sgoldaraz/mcu-board/PCB-RevA/OpenBotBrainREVA.pdf

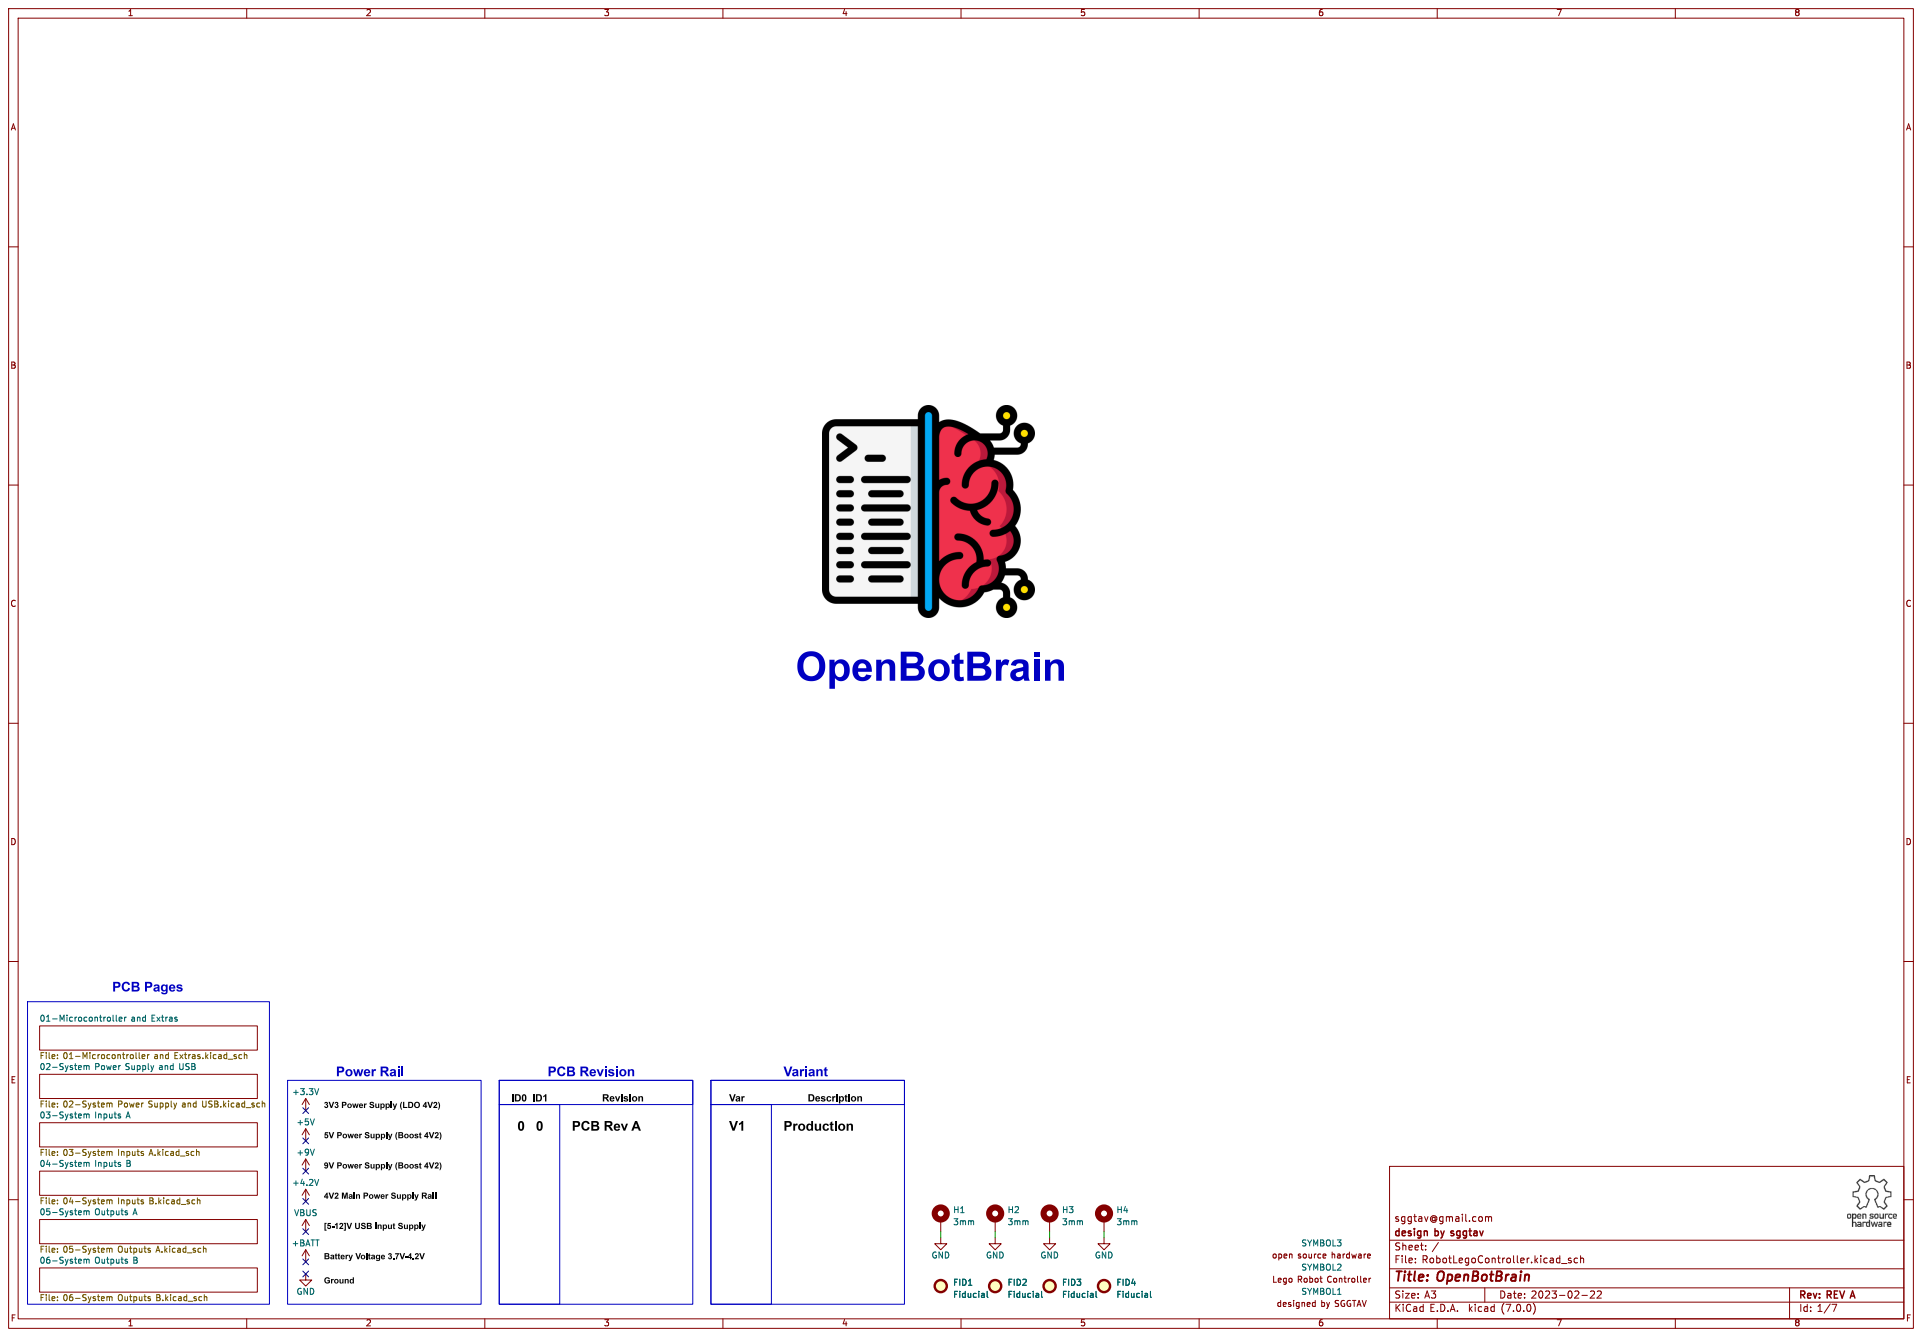
[picture p1: page 1]

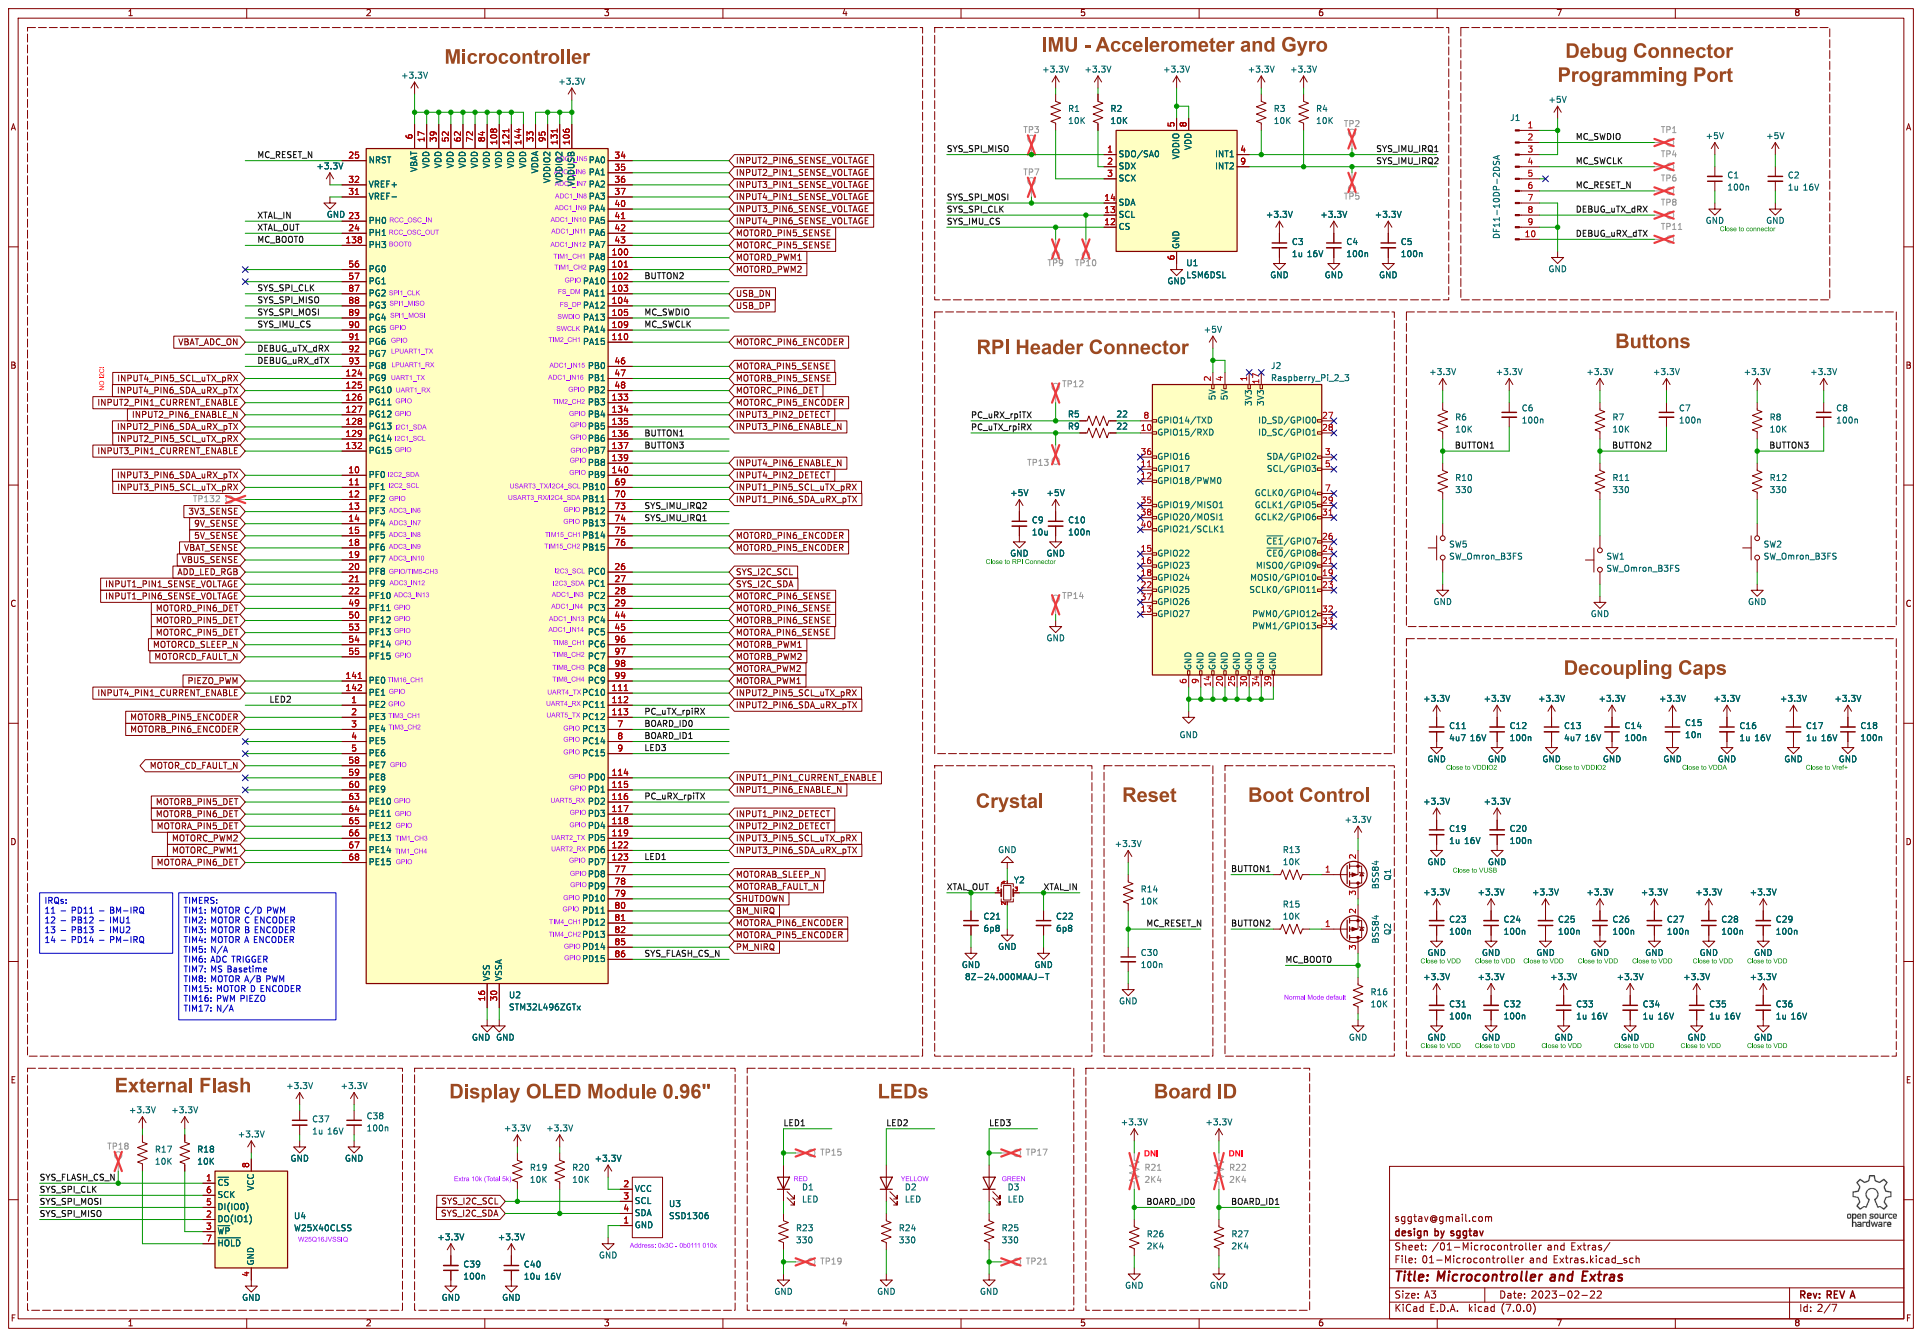
[picture p2: page 2]

IMU - Accelerometer and Gyro

SDO/SA0 1 CS 12 SCL 13 SDA 14 SDX 2 SCX 3

LSM6DSL SDO/SA0 1 CS 12 SCL 13 SDA 14 SDX 2 SCX 3

Normal Mode default RPI Header Connector

2 3 Q2 BSS84 GND GND GND GND

Close to VDDIO2 TIM4_CH1 GPIO
GPIO
Close to VDD GPIO
UART5_RX UART2_TX GPIO

Close to Vref+ GPIO

Close to VDDA GPIO

Close to VDDIO2 Board ID

TIM2: MOTOR C ENCODER
TIM3: MOTOR B ENCODER
TIM4: MOTOR A ENCODER
TIM5: N/A
TIM6: ADC TRIGGER
TIM7: MS Basetime TIM8: MOTOR A/B PWM

Close to VDD Display OLED Module 0.96"

4 DI(IO0) 5 SCK 6 ~{HOLD} 7 VCC

Id: 2/7 Title: Microcontroller and Extras

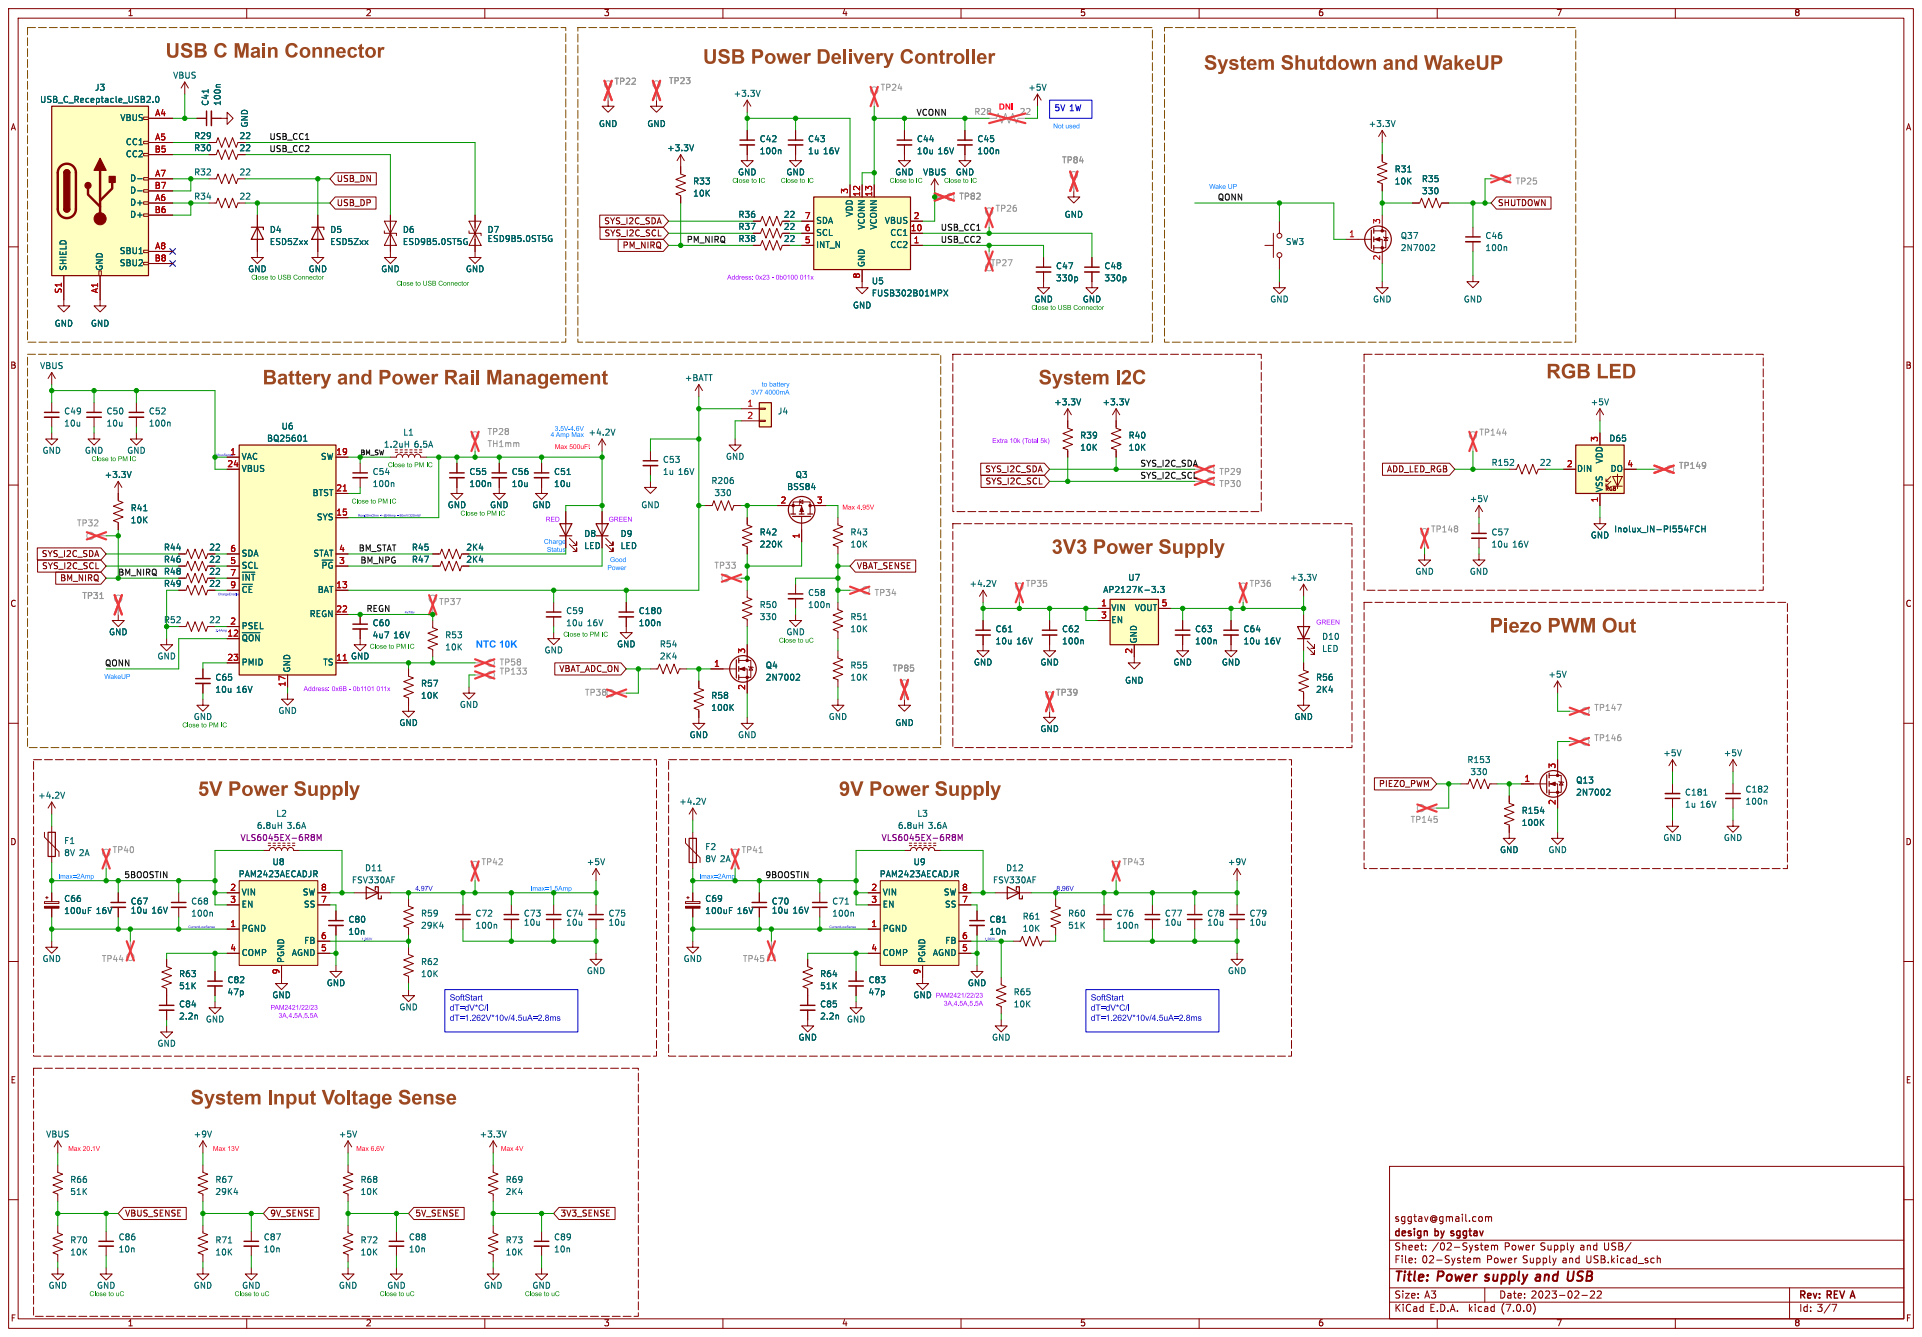
[picture p3: page 3]

Close to USB Connector Close to USB Connector USB C Main Connector

Wake UP 5V Power Supply

GND
Close to USB Connector

Extra 10k (Total 5k) Max 500uF! Close to PM IC Battery and Power Rail Management

10K GND
Close to PM IC

Good Power System Input Voltage Sense

1.262V Close to uC Max 13V

SoftStart dT=dV*C/I dT=1.262V*10v/4.5uA=2.8ms

Close to uC Max 20.1V

Id: 3/7 Title: Power supply and USB

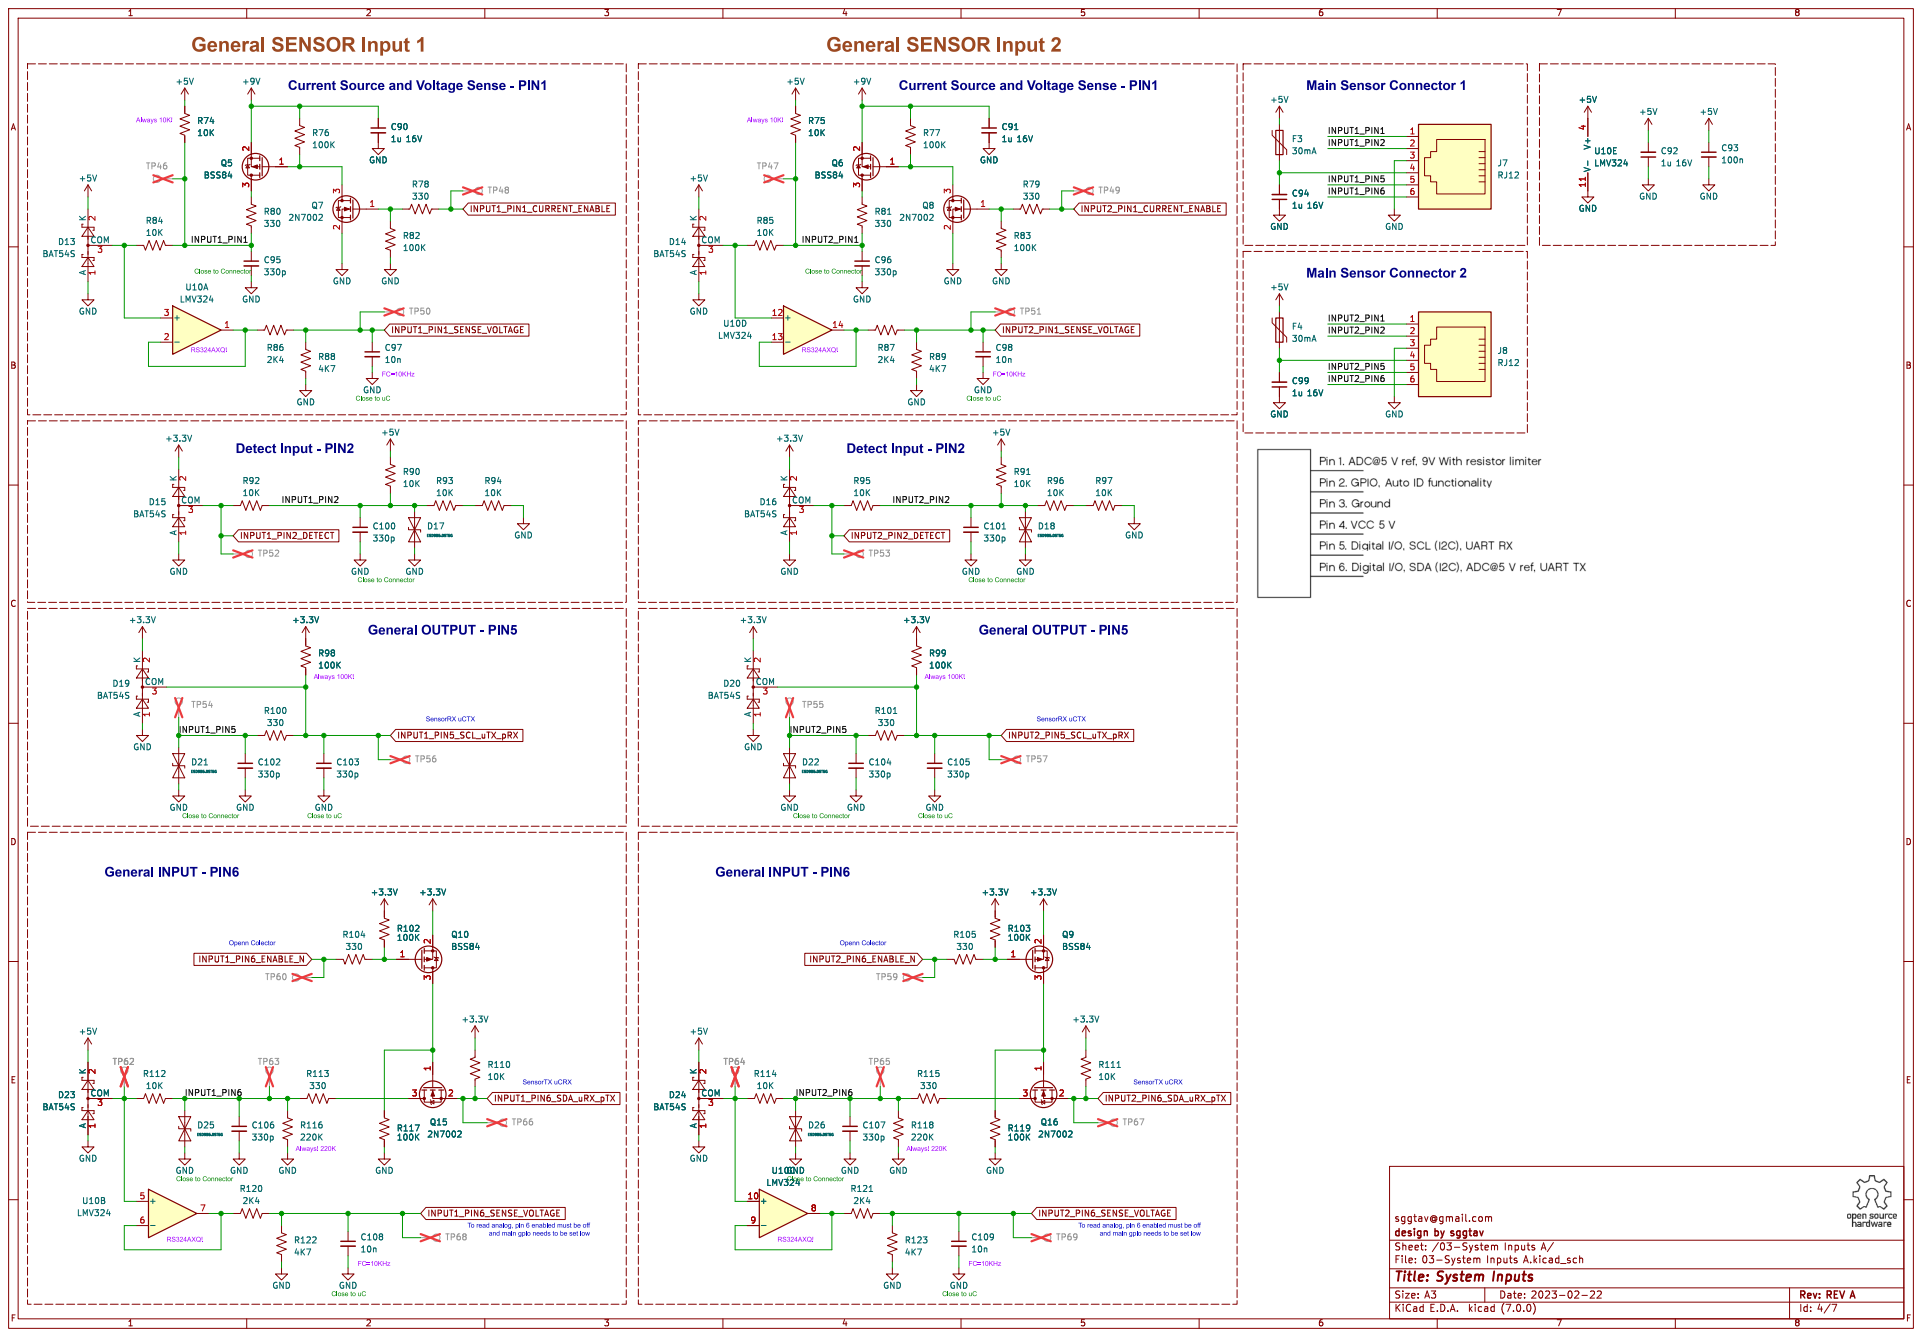
[picture p4: page 4]

FC=10KHz General SENSOR Input 2

RS324AXQ! Close to uC Current Source and Voltage Sense - PIN1

Current Source and Voltage Sense - PIN1

Close to Connector General INPUT - PIN6

Always 100K! Close to Connector

GND
SensorTX uCRX Close to Connector

SensorTX uCRX General INPUT - PIN6

To read analog, pin 6 enabled must be off and main gpio needs to be set low Openn Colector

Id: 4/7 Title: System Inputs

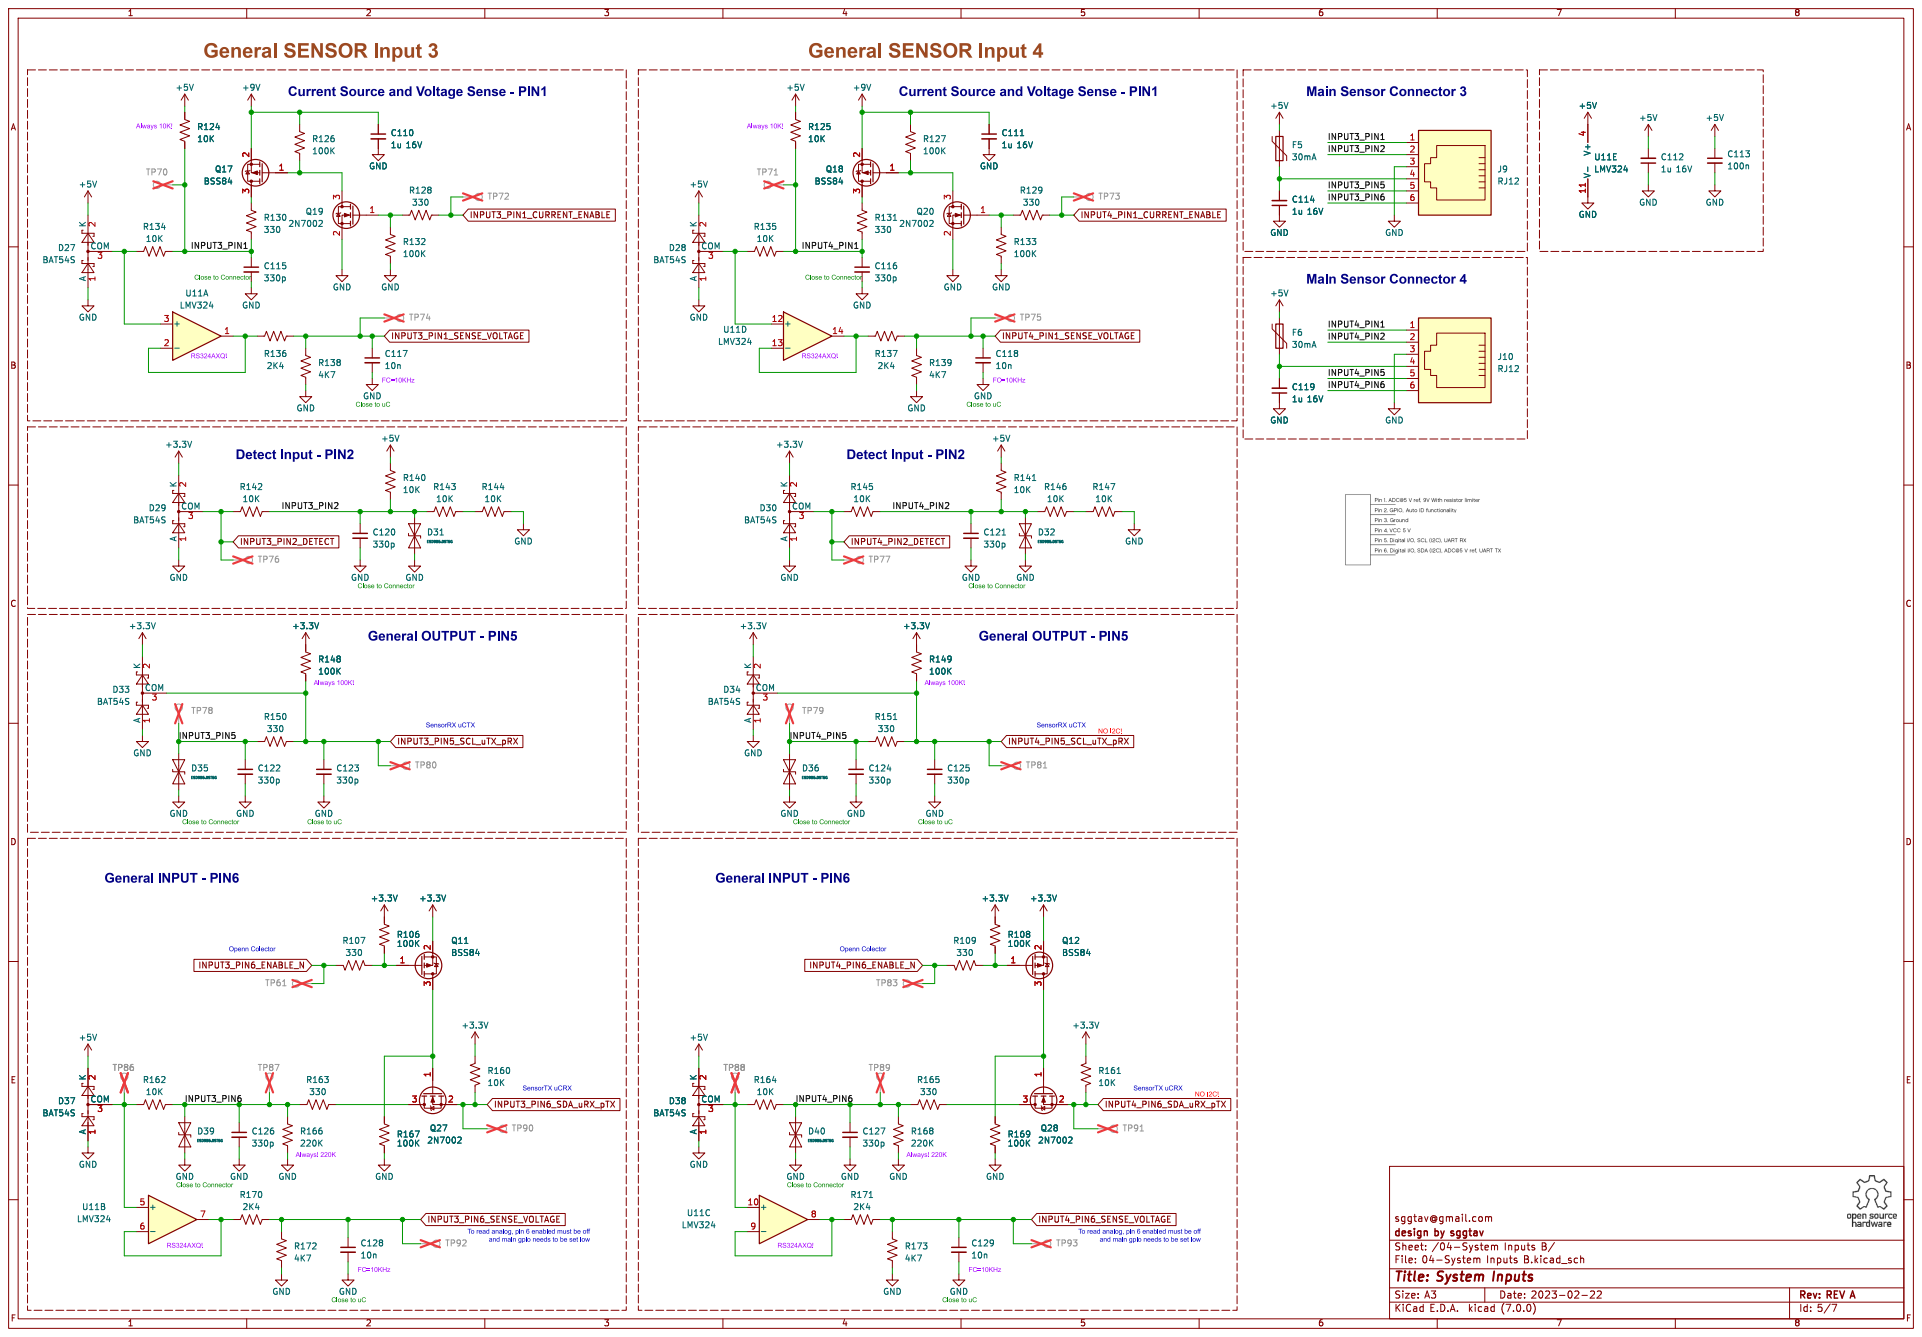
[picture p5: page 5]

Close to Connector General INPUT - PIN6

Openn Colector General INPUT - PIN6

SensorTX uCRX Close to uC

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

Id: 5/7 Title: System Inputs

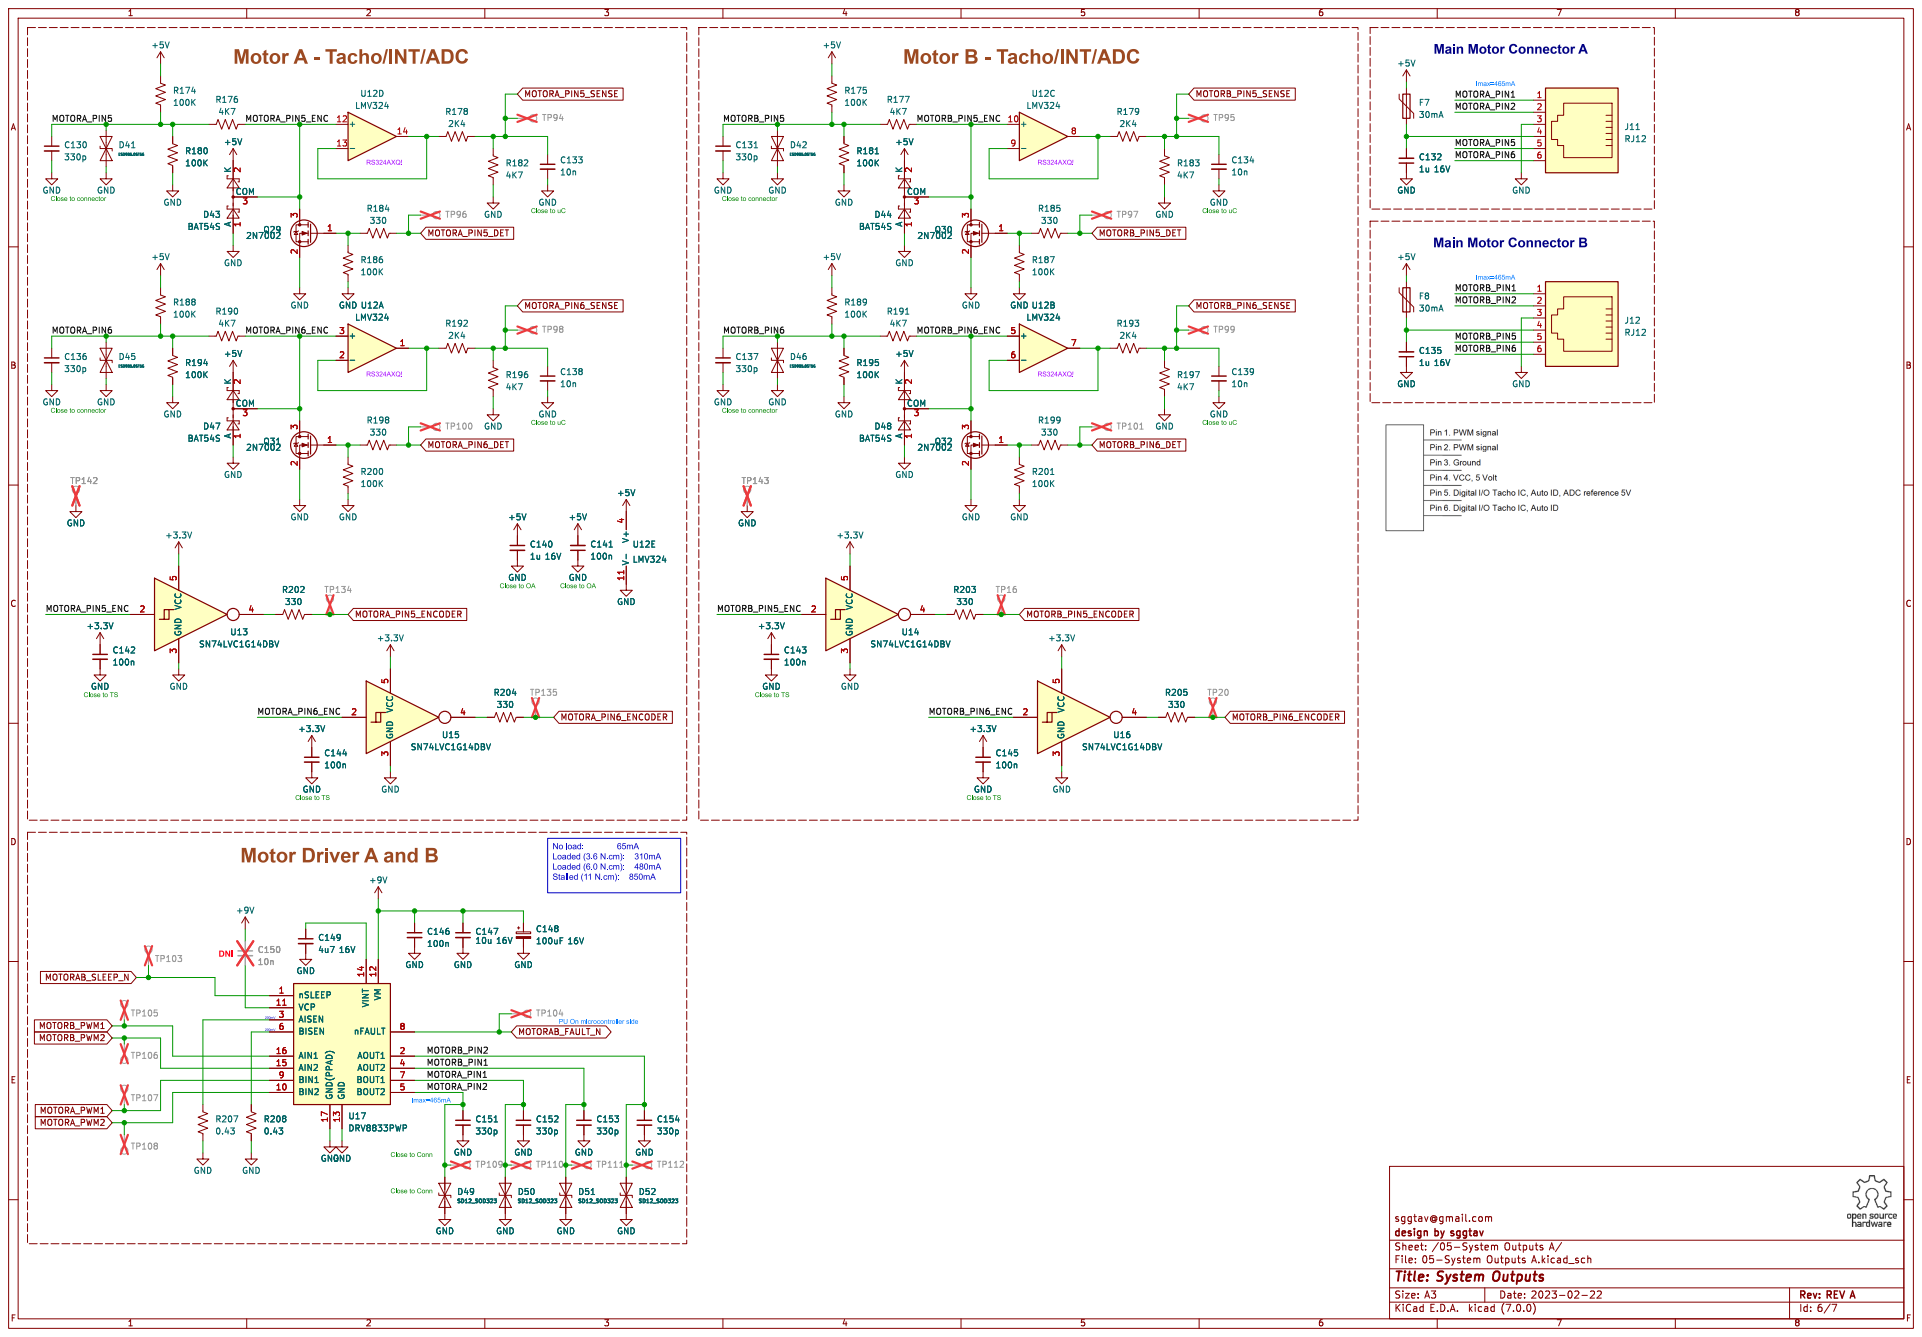
[picture p6: page 6]

MOTORA_PIN6 MOTORB_PIN6_ENC Motor A - Tacho/INT/ADC

Motor B - Tacho/INT/ADC

Imax=465mA Motor Driver A and B

GND
Close to OA Close to connector

Id: 6/7 Title: System Outputs

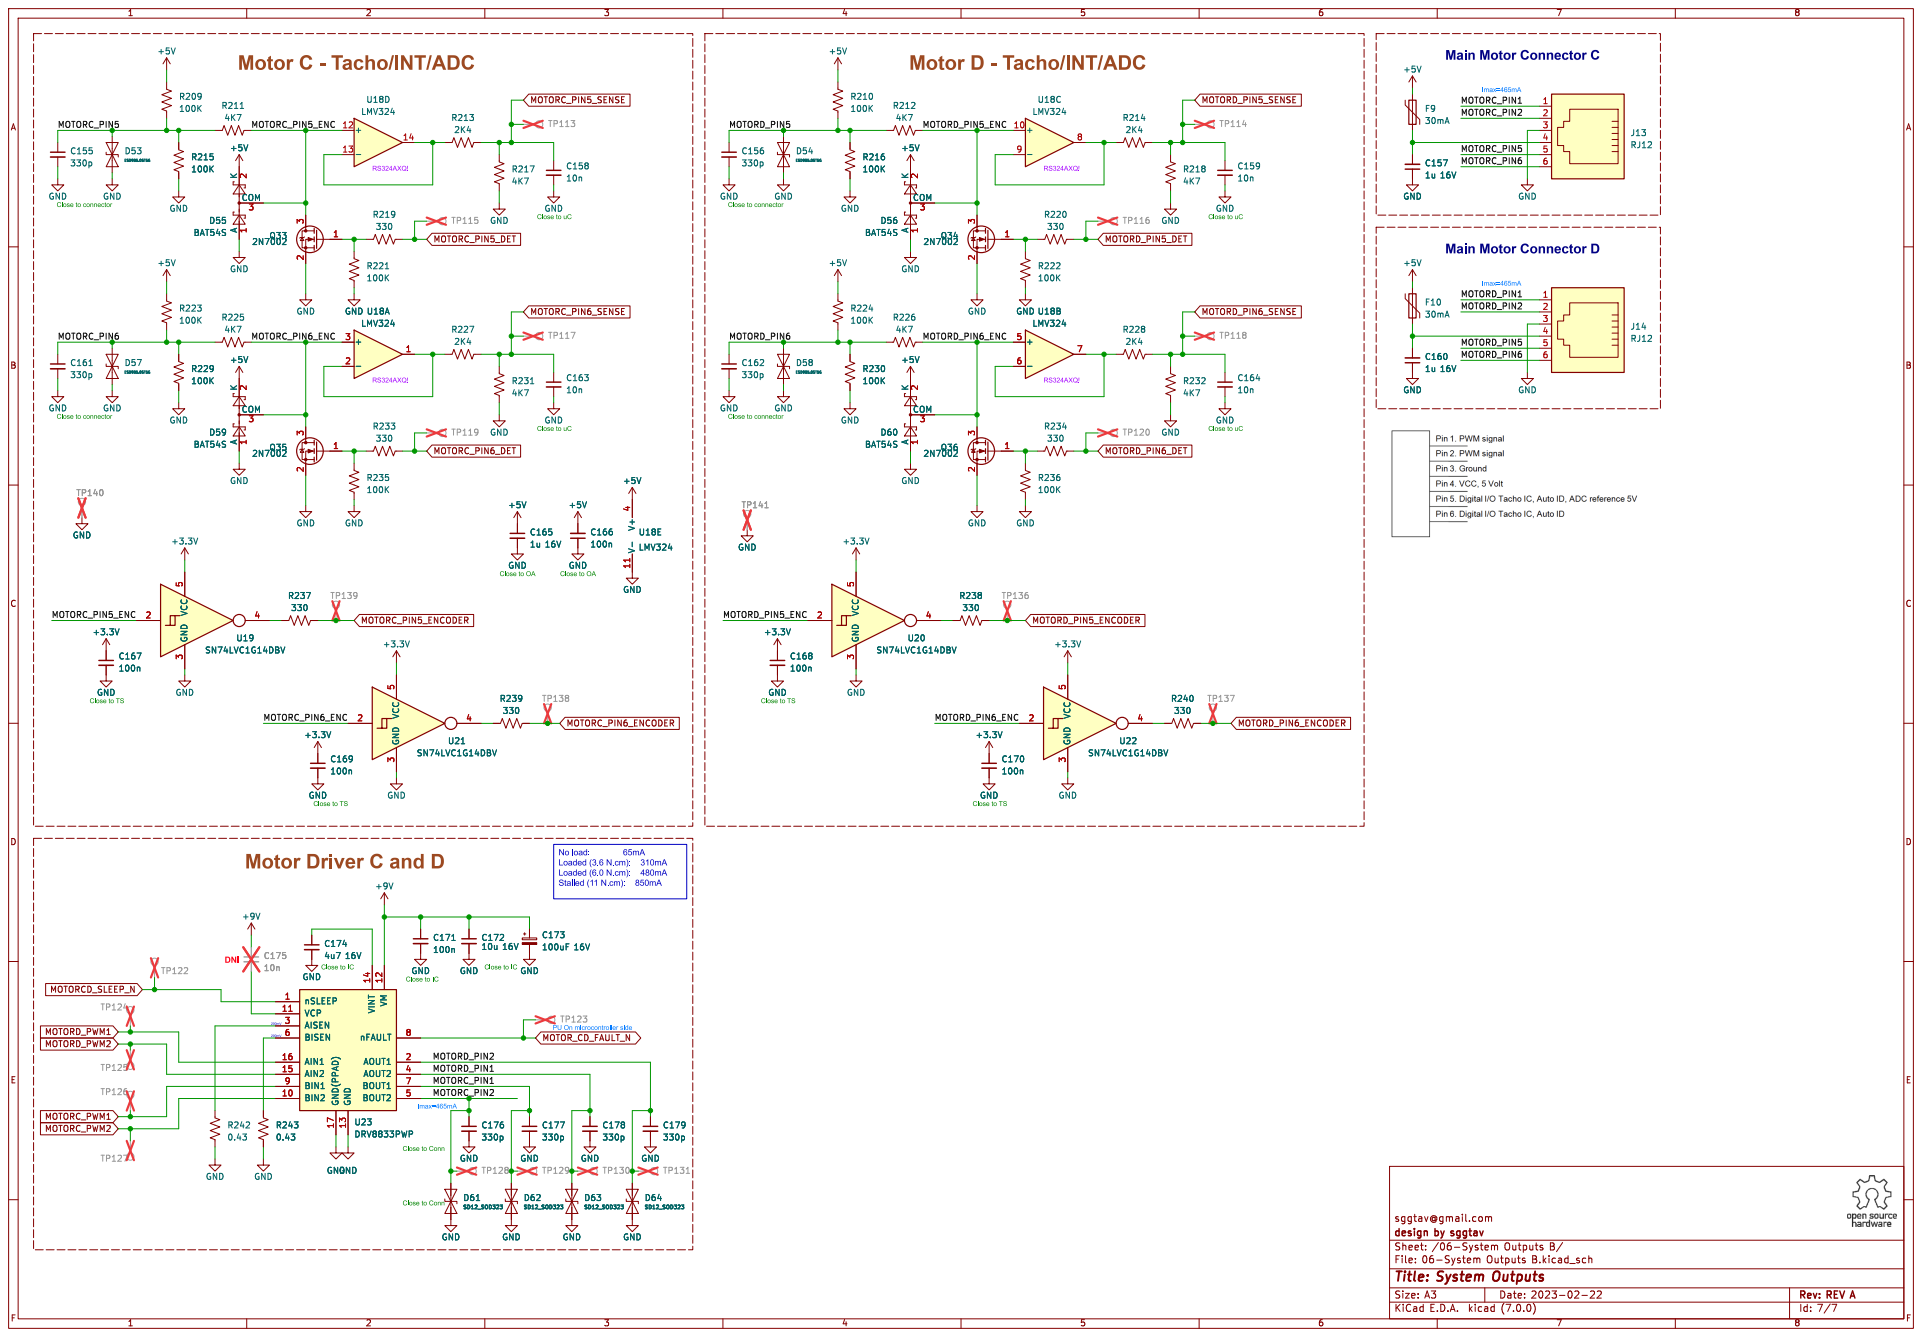
[picture p7: page 7]

Close to Conn Close to Conn Motor C - Tacho/INT/ADC

Imax=465mA Motor D - Tacho/INT/ADC

Close to OA Motor Driver C and D

Id: 7/7 Title: System Outputs
