sgoldaraz/mcu-board/PCB-RevB/RobotLegoController/RobotLegoController.kicad_pcb

## KiCad design PCB-RevB/RobotLegoController/RobotLegoController.kicad_pcb (2025-05-05)

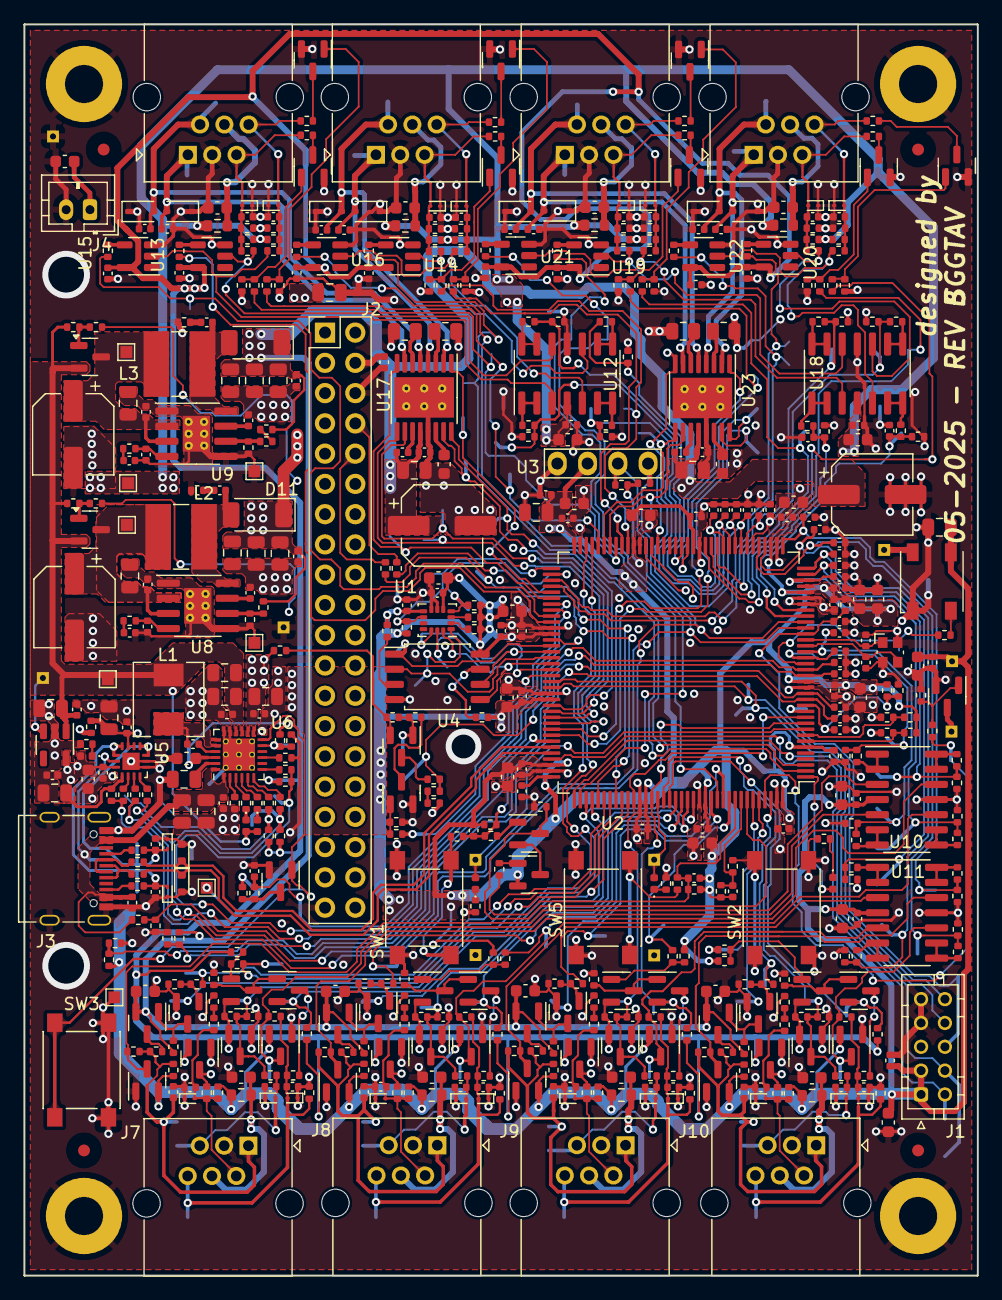
[picture p8: board RobotLegoController.kicad_pcb from above]

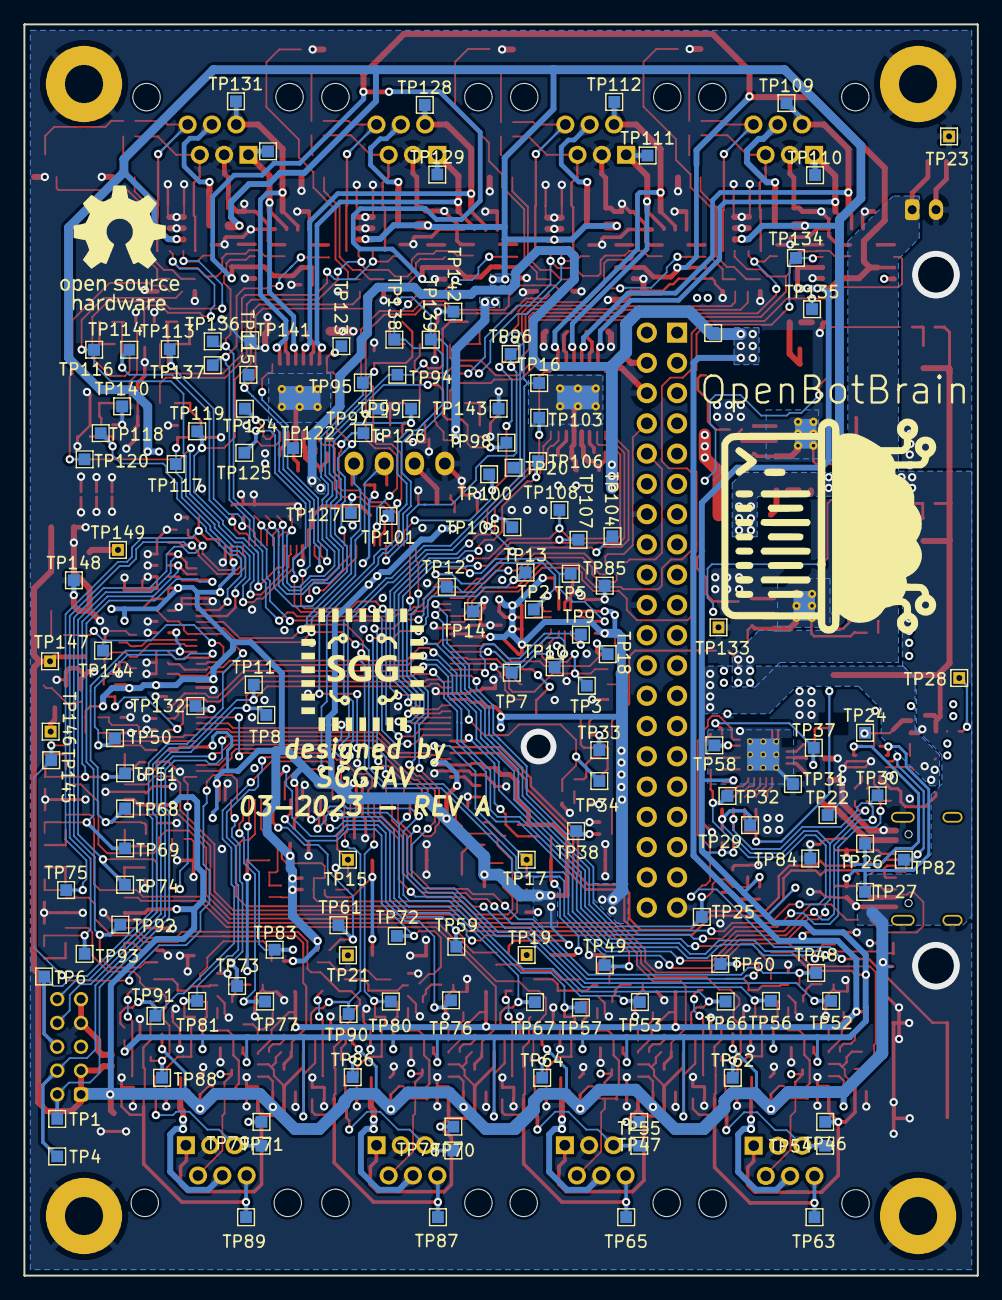
[picture p9: board RobotLegoController.kicad_pcb from below]

Board: 4 copper layers, 80.0 x 105.0 mm, 733 parts (142 on the bottom side), 315 nets.

Parts:
C1, C4, C5, C6, C7, C8, C10, C12, C14, C18, C20, C23, C24, C25, C26, C27, C28, C29, C30, C31, C32, C38, C39, C41, C42, C45, C46, C52, C54, C55, C58, C62, C63, C68, C71, C72, C76, C93, C113, C141, C142, C143, C144, C145, C146, C166, C167, C168, C169, C170, C171, C180, C182: 100n; C_0402_1005Metric
C2, C3, C16, C17, C19, C33, C34, C35, C36, C37, C43, C53, C90, C91, C92, C94, C99, C110, C111, C112, C114, C119, C132, C135, C140, C157, C160, C165, C181: 1u 16V; C_0603_1608Metric
C9, C49, C50, C51, C56, C73, C74, C75, C77, C78, C79: 10u; C_0805_2012Metric
C11, C13, C60, C149, C174: 4u7 16V; C_0603_1608Metric
C15, C80, C81, C86, C87, C88, C89, C97, C98, C108, C109, C117, C118, C128, C129, C133, C134, C138, C139, C150, C158, C159, C163, C164, C175: 10n; C_0402_1005Metric
C21, C22: 6p8; C_0402_1005Metric
C40, C44, C57, C59, C61, C64, C65, C67, C70, C147, C172: 10u 16V; C_0805_2012Metric
C47, C48, C95, C96, C100, C101, C102, C103, C104, C105, C106, C107, C115, C116, C120, C121, C122, C123, C124, C125, C126, C127, C130, C131, C136, C137, C151, C152, C153, C154, C155, C156, C161, C162, C176, C177, C178, C179, C183, C184: 330p; C_0402_1005Metric
C66, C69, C148, C173: 100uF 16V; CP_Elec_6.3x5.2
C82, C83: 47p; C_0402_1005Metric
C84, C85: 2.2n; C_0402_1005Metric
D1, D2, D3, D8, D9, D10: LED; LED_0402_1005Metric
D4, D5: ESD5Zxx; D_SOD-523
D6, D7, D17, D18, D21, D22, D25, D26, D31, D32, D35, D36, D39, D40, D41, D42, D45, D46, D53, D54, D57, D58: ESD9B5.0ST5G; D_SOD-923
D11, D12: FSV330AF; D_SOD-128
D13, D14, D15, D16, D19, D20, D23, D24, D27, D28, D29, D30, D33, D34, D37, D38: BAT54S; SOT-23
D49, D50, D51, D52, D61, D62, D63, D64: SD12_SOD323; D_SOD-323
D65: Inolux_IN-PI554FCH; LED_Inolux_IN-PI554FCH_PLCC4_5.0x5.0mm_P3.2mm
F3, F4, F5, F6, F7, F8, F9, F10: 30mA; R_0603_1608Metric
FID1, FID2, FID3, FID4: Fiducial; Fiducial_1mm_Mask3mm
H1, H2, H3, H4: 3mm; MountingHole_3.2mm_M3_Pad
J1: DF11-10DP-2DSA; JST_PHD_B10B-PHDSS_2x05_P2.00mm_Vertical
J2: Raspberry_Pi_2_3; PinHeader_2x20_P2.54mm_Vertical
J3: USB_C_Receptacle_USB2.0; USB_C_Receptacle_Palconn_UTC16-G
J4: Conn_01x02; JST_PH_B2B-PH-K_1x02_P2.00mm_Vertical
J7, J8, J9, J10, J11, J12, J13, J14: RJ12; RJ25_Wayconn_MJEA-660X1_Horizontal
L1: 1.2uH 6.5A; L_Chilisin_BMRA00050520
L2, L3: 6.8uH 3.6A; L_Ferrocore_DLG-0504
Q1, Q2, Q3, Q5, Q6, Q9, Q10, Q11, Q12, Q17, Q18: BSS84; SOT-23
Q4, Q7, Q8, Q13, Q15, Q16, Q19, Q20, Q27, Q28, Q29, Q30, Q31, Q32, Q33, Q34, Q35, Q36, Q37: 2N7002; SOT-23
Q14, Q21: Si2371EDS; SOT-23
R1, R2, R3, R4, R6, R7, R8, R13, R14, R15, R16, R17, R18, R19, R20, R31, R33, R39, R40, R41, R43, R51, R53, R55, R57, R61, R62, R63, R65, R68, R70, R71, R72, R73, R74, R75, R84, R85, R90, R91, R92, R93, R94, R95, R96, R97, R110, R111, R112, R114, R124, R125, R134, R135, R140, R141, R142, R143, R144, R145, R146, R147, R160, R161, R162, R164: 10K; R_0402_1005Metric
R5, R9, R28, R29, R30, R32, R34, R36, R37, R38, R44, R46, R48, R49, R52, R152: 22; R_0402_1005Metric
R10, R11, R12, R23, R24, R25, R35, R50, R78, R79, R80, R81, R100, R101, R104, R105, R107, R109, R113, R115, R128, R129, R130, R131, R150, R151, R153, R163, R165, R184, R185, R198, R199, R202, R203, R204, R205, R206, R219, R220, R233, R234, R237, R238, R239, R240, R246, R247: 330; R_0402_1005Metric
R21, R22, R26, R27, R45, R47, R54, R56, R69, R86, R87, R120, R121, R136, R137, R157, R159, R170, R171, R178, R179, R192, R193, R213, R214, R227, R228: 2K4; R_0402_1005Metric
R42, R116, R118, R166, R168: 220K; R_0402_1005Metric
R58, R76, R77, R82, R83, R98, R99, R102, R103, R106, R108, R117, R119, R126, R127, R132, R133, R148, R149, R154, R167, R169, R174, R175, R180, R181, R186, R187, R188, R189, R194, R195, R200, R201, R209, R210, R215, R216, R221, R222, R223, R224, R229, R230, R235, R236: 100K; R_0402_1005Metric
R59, R64, R67, R156, R158: 29K4; R_0402_1005Metric
R60, R66: 51K; R_0402_1005Metric
R88, R89, R122, R123, R138, R139, R155, R172, R173, R176, R177, R182, R183, R190, R191, R196, R197, R211, R212, R217, R218, R225, R226, R231, R232, R241, R244, R245, R248, R249, R250, R251: 4K7; R_0402_1005Metric
R207, R208, R242, R243: 0.43; R_0805_2012Metric
SW1, SW2, SW3, SW5: SW_Omron_B3FS; SW_Push_1P1T_NO_6x6mm_H9.5mm
SYMBOL1: sggtav_logo
SYMBOL2: lego_robot_controller
SYMBOL3: open_source
TP1, TP2, TP3, TP4, TP5, TP6, TP7, TP8, TP9, TP10, TP11, TP12, TP13, TP14, TP16, TP18, TP20, TP22, TP24, TP25, TP26, TP27, TP29, TP30, TP31, TP32, TP33, TP34, TP35, TP36, TP37, TP38, TP39, TP40, TP41, TP42, TP43, TP44, TP45, TP46, TP47, TP48, TP49, TP50, TP51, TP52, TP53, TP54, TP55, TP56, TP57, TP58, TP59, TP60, TP61, TP62, TP63, TP64, TP65, TP66, TP67, TP68, TP69, TP70, TP71, TP72, TP73, TP74, TP75, TP76, TP77, TP78, TP79, TP80, TP81, TP82, TP83, TP84, TP85, TP86, TP87, TP88, TP89, TP90, TP91, TP92, TP93, TP94, TP95, TP96, TP97, TP98, TP99, TP100, TP101, TP103, TP104, TP105, TP106, TP107, TP108, TP109, TP110, TP111, TP112, TP113, TP114, TP115, TP116, TP117, TP118, TP119, TP120, TP122, TP123, TP124, TP125, TP126, TP127, TP128, TP129, TP130, TP131, TP132, TP134, TP135, TP136, TP137, TP138, TP139, TP140, TP141, TP142, TP143, TP144, TP145, TP148: S1mm; TestPoint_Pad_1.0x1.0mm
TP15, TP17, TP19, TP21, TP23, TP28, TP133, TP146, TP147, TP149: TH1mm; TestPoint_THTPad_1.0x1.0mm_Drill0.5mm
U1: LSM6DSL; LGA-14_3x2.5mm_P0.5mm_LayoutBorder3x4y
U2: STM32L496ZGTx; LQFP-144_20x20mm_P0.5mm
U3: SSD1306; 128x64OLED
U4: W25X40CLSS; SOIC-8_5.275x5.275mm_P1.27mm
U5: FUSB302B01MPX; WQFN-14-1EP_2.5x2.5mm_P0.5mm_EP1.45x1.45mm
U6: BQ25601; Texas_S-PWQFN-N24_EP2.7x2.7mm_ThermalVias
U7: AP2127K-3.3; SOT-23-5
U8, U9: PAM2423AECADJR; SOIC-8-1EP_3.9x4.9mm_P1.27mm_EP2.29x3mm_ThermalVias
U10, U11, U12, U18: LMV324; SOIC-14_3.9x8.7mm_P1.27mm
U13, U14, U15, U16, U19, U20, U21, U22: SN74LVC1G14DBV; SOT-23-5
U17, U23: DRV8833PWP; HTSSOP-16-1EP_4.4x5mm_P0.65mm_EP3.4x5mm_Mask2.46x2.31mm_The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
Y2: 8Z-24.000MAAJ-T; Crystal_SMD_Abracon_ABM10-4Pin_2.5x2.0mm

Connections:
3V3_SENSE: C89.1, R69.1, R73.2, U2.13 (PF3)
5VON: R157.1, U2.59 (PE8)
5V_SENSE: C88.1, R68.1, R72.2, U2.15 (PF5)
9VON: R159.1, U2.60 (PE9)
9V_SENSE: C87.1, R67.1, R71.2, U2.14 (PF4)
+3.3V: C3.1, C4.1, C5.1, C6.1, C7.1, C8.1, C11.1, C12.2, C13.1, C14.2, C15.1, C16.1, C17.1, C18.2, C19.1, C20.2, C23.2, C24.2, C25.2, C26.2, C27.2, C28.2, C29.2, C31.2, C32.2, C33.1, C34.1, C35.1, C36.1, C37.1, C38.1, C39.2, C40.1, C42.1, C43.1, C63.1, C64.1, C142.1, C143.1, C144.1, C145.1, C167.1, C168.1, C169.1, C170.1, D10.2 (A), D15.2 (K), D16.2 (K), D19.2 (K), D20.2 (K), D29.2 (K), D30.2 (K), D33.2 (K), D34.2 (K), Q1.2 (S), Q9.2 (S), Q10.2 (S), Q11.2 (S), Q12.2 (S), R1.2, R2.2, R3.2, R4.2, R6.2, R7.2, R8.2, R14.2, R17.2, R18.2, R19.2, R20.2, R21.2, R22.2, R31.2, R33.2, R39.2, R40.2, R41.2, R69.2, R98.2, R99.2, R102.2, R103.2, R106.2, R108.2, R110.1, R111.1, R148.2, R149.2, R160.1, R161.1, TP36.1, U1.5 (VDDIO), U1.8 (VDD), U2.6 (VBAT), U2.17 (VDD), U2.32 (VREF+), U2.33 (VDDA), U2.39 (VDD), U2.52 (VDD), U2.62 (VDD), U2.72 (VDD), U2.84 (VDD), U2.95 (VDDIO2), U2.106 (VDDUSB), U2.108 (VDD), U2.121 (VDD), U2.131 (VDDIO2), U2.144 (VDD), U3.2 (VCC), U4.8 (VCC), U5.3 (VDD), U5.4 (VDD), U7.5 (VOUT), U13.5 (VCC), U14.5 (VCC), U15.5 (VCC), U16.5 (VCC), U19.5 (VCC), U20.5 (VCC), U21.5 (VCC), U22.5 (VCC)
+4V: C51.1, C55.1, C56.1, C61.1, C62.1, D8.2 (A), D9.2 (A), L1.2, Q14.2 (S), Q21.2 (S), R64.2, R158.2, TP28.1, TP35.1, U6.15 (SYS), U6.16 (SYS), U7.1 (VIN), U7.3 (EN)
+5V: C1.2, C2.1, C9.1, C10.1, C57.1, C72.1, C73.1, C74.1, C75.1, C92.2, C93.1, C112.2, C113.1, C140.1, C141.2, C165.1, C166.2, C181.2, C182.1, D11.1 (K), D13.2 (K), D14.2 (K), D23.2 (K), D24.2 (K), D27.2 (K), D28.2 (K), D37.2 (K), D38.2 (K), D65.3 (VDD), F3.2, F4.2, F5.2, F6.2, F7.2, F8.2, F9.2, F10.2, J1.1, J1.3, J2.2 (5V), J2.4 (5V), R28.2, R59.2, R68.2, R74.2, R75.2, R90.2, R91.2, R124.2, R125.2, R140.2, R141.2, R174.2, R175.2, R188.2, R189.2, R209.2, R210.2, R223.2, R224.2, TP42.1, TP147.1, U10.4 (V+), U11.4 (V+), U12.4 (V+), U18.4 (V+)
+9V: C76.1, C77.1, C78.1, C79.1, C90.1, C91.1, C110.1, C111.1, C146.1, C147.1, C148.1, C150.1, C171.1, C172.1, C173.1, C175.1, D12.1 (K), Q5.2 (S), Q6.2 (S), Q17.2 (S), Q18.2 (S), R60.2, R67.2, R76.2, R77.2, R126.2, R127.2, TP43.1, U17.12 (VM), U23.12 (VM)
+BATT: C53.1, C59.1, C180.1, J4.1, R206.1, U6.13 (BAT), U6.14 (BAT)
/01-Microcontroller and Extras/BOARD_ID0: R21.1, R26.2, U2.7 (PC13)
/01-Microcontroller and Extras/BOARD_ID1: R22.1, R27.2, U2.8 (PC14)
/01-Microcontroller and Extras/BUTTON1: C6.2, R6.1, R10.2, R13.2, U2.136 (PB6)
/01-Microcontroller and Extras/BUTTON2: C7.2, R7.1, R11.2, R15.2, U2.102 (PA10)
/01-Microcontroller and Extras/BUTTON3: C8.2, R8.1, R12.2, U2.137 (PB7)
/01-Microcontroller and Extras/DEBUG_uRX_dTX: J1.10, TP11.1, U2.93 (PG8)
/01-Microcontroller and Extras/DEBUG_uTX_dRX: J1.8, TP8.1, U2.92 (PG7)
/01-Microcontroller and Extras/LED1: D1.2 (A), TP15.1, U2.123 (PD7)
/01-Microcontroller and Extras/LED2: D2.2 (A), U2.1 (PE2)
/01-Microcontroller and Extras/LED3: D3.2 (A), TP17.1, U2.9 (PC15)
/01-Microcontroller and Extras/MC_BOOT0: Q2.3 (D), R16.1, U2.138 (PH3)
/01-Microcontroller and Extras/MC_RESET_N: C30.1, J1.6, R14.1, TP6.1, U2.25 (NRST)
/01-Microcontroller and Extras/MC_SWCLK: J1.4, TP4.1, U2.109 (PA14)
/01-Microcontroller and Extras/MC_SWDIO: J1.2, TP1.1, U2.105 (PA13)
/01-Microcontroller and Extras/PC_uRX_rpiTX: R5.1, TP12.1, U2.116 (PD2)
/01-Microcontroller and Extras/PC_uTX_rpiRX: R9.1, TP13.1, U2.113 (PC12)
/01-Microcontroller and Extras/SYS_FLASH_CS_N: TP18.1, U2.86 (PD15), U4.1 (~CS)
/01-Microcontroller and Extras/SYS_IMU_CS: TP9.1, U1.12 (CS), U2.90 (PG5)
/01-Microcontroller and Extras/SYS_IMU_IRQ1: R3.1, TP2.1, U1.4 (INT1), U2.74 (PB13)
/01-Microcontroller and Extras/SYS_IMU_IRQ2: R4.1, TP5.1, U1.9 (INT2), U2.73 (PB12)
/01-Microcontroller and Extras/SYS_SPI_CLK: TP10.1, U1.13 (SCL), U2.87 (PG2), U4.6 (SCK)
/01-Microcontroller and Extras/SYS_SPI_MISO: TP3.1, U1.1 (SDO/SA0), U2.88 (PG3), U4.2 (DO(IO1))
/01-Microcontroller and Extras/SYS_SPI_MOSI: TP7.1, U1.14 (SDA), U2.89 (PG4), U4.5 (DI(IO0))
/01-Microcontroller and Extras/XTAL_IN: C22.1, U2.23 (PH0), Y2.3
/01-Microcontroller and Extras/XTAL_OUT: C21.1, U2.24 (PH1), Y2.1
/02-System Power Supply and USB/5BOOSTIN: C66.1, C67.1, C68.1, L2.1, Q14.3 (D), TP40.1, U8.2 (VIN), U8.3 (EN)
/02-System Power Supply and USB/9BOOSTIN: C69.1, C70.1, C71.1, L3.1, Q21.3 (D), TP41.1, U9.2 (VIN), U9.3 (EN)
/02-System Power Supply and USB/BM_NPG: R47.1, U6.3 (~PG)
/02-System Power Supply and USB/BM_STAT: R45.1, U6.4 (STAT)
/02-System Power Supply and USB/BM_SW: C54.1, L1.1, U6.19 (SW), U6.20 (SW)
/02-System Power Supply and USB/QONN: Q37.1 (G), SW3.2, U6.12 (~QON)
/02-System Power Supply and USB/REGN: C60.1, R53.2, TP37.1, U6.22 (REGN)
/02-System Power Supply and USB/USB_CC1: C48.1, D7.2 (A2), R29.2, TP26.1, U5.10 (CC1), U5.11 (CC1)
/02-System Power Supply and USB/USB_CC2: C47.1, D6.2 (A2), R30.2, TP27.1, U5.1 (CC2), U5.14 (CC2)
/02-System Power Supply and USB/VCONN: C44.1, C45.1, R28.1, TP24.1, U5.12 (VCONN), U5.13 (VCONN)
/03-System Inputs A/INPUT1_PIN1: C95.1, J7.1, R74.1, R80.1, R84.2, TP46.1
/03-System Inputs A/INPUT1_PIN2: C100.1, D17.2 (A2), J7.2, R90.1, R92.2, R93.2
/03-System Inputs A/INPUT1_PIN5: C102.1, D21.2 (A2), J7.5, R100.2, TP54.1
/03-System Inputs A/INPUT1_PIN6: C106.1, D25.2 (A2), J7.6, R112.2, R113.2, R116.1, TP63.1
/03-System Inputs A/INPUT2_PIN1: C96.1, J8.1, R75.1, R81.1, R85.1, TP47.1
/03-System Inputs A/INPUT2_PIN2: C101.1, D18.2 (A2), J8.2, R91.1, R95.2, R96.2
/03-System Inputs A/INPUT2_PIN5: C104.1, D22.2 (A2), J8.5, R101.2, TP55.1
/03-System Inputs A/INPUT2_PIN6: C107.1, D26.2 (A2), J8.6, R114.2, R115.2, R118.1, TP65.1
/04-System Inputs B/INPUT3_PIN1: C115.1, J9.1, R124.1, R130.1, R134.1, TP70.1
/04-System Inputs B/INPUT3_PIN2: C120.1, D31.2 (A2), J9.2, R140.1, R142.2, R143.2
/04-System Inputs B/INPUT3_PIN5: C122.1, D35.2 (A2), J9.5, R150.2, TP78.1
/04-System Inputs B/INPUT3_PIN6: C126.1, D39.2 (A2), J9.6, R162.2, R163.2, R166.1, TP87.1
/04-System Inputs B/INPUT4_PIN1: C116.1, J10.1, R125.1, R131.1, R135.1, TP71.1
/04-System Inputs B/INPUT4_PIN2: C121.1, D32.2 (A2), J10.2, R141.1, R145.2, R146.2
/04-System Inputs B/INPUT4_PIN5: C124.1, D36.2 (A2), J10.5, R151.2, TP79.1
/04-System Inputs B/INPUT4_PIN6: C127.1, D40.2 (A2), J10.6, R164.2, R165.2, R168.1, TP89.1
/05-System Outputs A/MOTORA_PIN1: C152.1, D50.2 (A2), J11.1, TP110.1, U17.7 (BOUT1)
/05-System Outputs A/MOTORA_PIN2: C151.1, D49.2 (A2), J11.2, TP109.1, U17.5 (BOUT2)
/05-System Outputs A/MOTORA_PIN5: C130.1, D41.2 (A2), J11.5, R174.1, R176.2, R180.2, R241.1
/05-System Outputs A/MOTORA_PIN5_ENC: R176.1, U12.12 (+), U13.2
/05-System Outputs A/MOTORA_PIN6: C136.1, D45.2 (A2), J11.6, R188.1, R190.2, R194.2, R244.1
/05-System Outputs A/MOTORA_PIN6_ENC: R190.1, U12.3 (+), U15.2
/05-System Outputs A/MOTORB_PIN1: C153.1, D51.2 (A2), J12.1, TP111.1, U17.4 (AOUT2)
/05-System Outputs A/MOTORB_PIN2: C154.1, D52.2 (A2), J12.2, TP112.1, U17.2 (AOUT1)
/05-System Outputs A/MOTORB_PIN5: C131.1, D42.2 (A2), J12.5, R175.1, R177.2, R181.2, R249.1
/05-System Outputs A/MOTORB_PIN5_ENC: R177.1, U12.10 (+), U14.2
/05-System Outputs A/MOTORB_PIN6: C137.1, D46.2 (A2), J12.6, R189.1, R191.2, R195.2, R248.1
/05-System Outputs A/MOTORB_PIN6_ENC: R191.1, U12.5 (+), U16.2
/06-System Outputs B/MOTORC_PIN1: C177.1, D62.2 (A2), J13.1, TP129.1, U23.7 (BOUT1)
/06-System Outputs B/MOTORC_PIN2: C176.1, D61.2 (A2), J13.2, TP128.1, U23.5 (BOUT2)
/06-System Outputs B/MOTORC_PIN5: C155.1, D53.2 (A2), J13.5, R155.1, R209.1, R211.2, R215.2
/06-System Outputs B/MOTORC_PIN5_ENC: R211.1, U18.12 (+), U19.2
/06-System Outputs B/MOTORC_PIN6: C161.1, D57.2 (A2), J13.6, R223.1, R225.2, R229.2, R245.1
/06-System Outputs B/MOTORC_PIN6_ENC: R225.1, U18.3 (+), U21.2
/06-System Outputs B/MOTORD_PIN1: C178.1, D63.2 (A2), J14.1, TP130.1, U23.4 (AOUT2)
/06-System Outputs B/MOTORD_PIN2: C179.1, D64.2 (A2), J14.2, TP131.1, U23.2 (AOUT1)
/06-System Outputs B/MOTORD_PIN5: C156.1, D54.2 (A2), J14.5, R210.1, R212.2, R216.2, R251.1
/06-System Outputs B/MOTORD_PIN5_ENC: R212.1, U18.10 (+), U20.2
/06-System Outputs B/MOTORD_PIN6: C162.1, D58.2 (A2), J14.6, R224.1, R226.2, R230.2, R250.1
/06-System Outputs B/MOTORD_PIN6_ENC: R226.1, U18.5 (+), U22.2
ADD_LED_RGB: R152.1, TP144.1, U2.20 (PF8)
BM_NIRQ: R41.1, R48.1, TP32.1, U2.80 (PD11)
GND: C1.1, C2.2, C3.2, C4.2, C5.2, C9.2, C10.2, C11.2, C12.1, C13.2, C14.1, C15.2, C16.2, C17.2, C18.1, C19.2, C20.1, C21.2, C22.2, C23.1, C24.1, C25.1, C26.1, C27.1, C28.1, C29.1, C30.2, C31.1, C32.1, C33.2, C34.2, C35.2, C36.2, C37.2, C38.2, C39.1, C40.2, C41.2, C42.2, C43.2, C44.2, C45.2, C46.2, C47.2, C48.2, C49.2, C50.2, C51.2, C52.2, C53.2, C55.2, C56.2, C57.2, C58.2, C59.2, C60.2, C61.2, C62.2, C63.2, C64.2, C65.2, C66.2, C67.2, C68.2, C69.2, C70.2, C71.2, C72.2, C73.2, C74.2, C75.2, C76.2, C77.2, C78.2, C79.2, C80.2, C81.2, C82.2, C83.2, C84.2, C85.2, C86.2, C87.2, C88.2, C89.2, C90.2, C91.2, C92.1, C93.2, C94.1, C95.2, C96.2, C97.2, C98.2, C99.1, C100.2, C101.2, C102.2, C103.2, C104.2, C105.2, C106.2, C107.2, C108.2, C109.2, C110.2, C111.2, C112.1, C113.2, C114.1, C115.2, C116.2, C117.2, C118.2, C119.1, C120.2, C121.2, C122.2, C123.2, C124.2, C125.2, C126.2, C127.2, C128.2, C129.2, C130.2, C131.2, C132.1, C133.2, C134.2, C135.1, C136.2, C137.2, C138.2, C139.2, C140.2, C141.1, C142.2, C143.2, C144.2, C145.2, C146.2, C147.2, C148.2, C149.2, C151.2, C152.2, C153.2, C154.2, C155.2, C156.2, C157.1, C158.2, C159.2, C160.1, C161.2, C162.2, C163.2, C164.2, C165.2, C166.1, C167.2, C168.2, C169.2, C170.2, C171.2, C172.2, C173.2, C174.2, C176.2, C177.2, C178.2, C179.2, C180.2, C181.1, C182.2, D4.2 (A), D5.2 (A), D6.1 (A1), D7.1 (A1), D13.1 (A), D14.1 (A), D15.1 (A), D16.1 (A), D17.1 (A1), D18.1 (A1), D19.1 (A), D20.1 (A), D21.1 (A1), D22.1 (A1), D23.1 (A), D24.1 (A), D25.1 (A1), D26.1 (A1), D27.1 (A), D28.1 (A), D29.1 (A), D30.1 (A), D31.1 (A1), D32.1 (A1), D33.1 (A), D34.1 (A), D35.1 (A1), D36.1 (A1), D37.1 (A), D38.1 (A), D39.1 (A1), D40.1 (A1), D41.1 (A1), D42.1 (A1), D45.1 (A1), D46.1 (A1), D49.1 (A1), D50.1 (A1), D51.1 (A1), D52.1 (A1), D53.1 (A1), D54.1 (A1), D57.1 (A1), D58.1 (A1), D61.1 (A1), D62.1 (A1), D63.1 (A1), D64.1 (A1), D65.1 (VSS), H1.1, H2.1, H3.1, H4.1, J1.7, J1.9, J2.6 (GND), J2.9 (GND), J2.14 (GND), J2.20 (GND), J2.25 (GND), J2.30 (GND), J2.34 (GND), J2.39 (GND), J3.A1 (GND), J3.A12 (GND), J3.B1 (GND), J3.B12 (GND), J3.S1 (SHIELD), J4.2, J7.3, J8.3, J9.3, J10.3, J11.3, J12.3, J13.3, J14.3, Q4.2 (S), Q7.2 (S), Q8.2 (S), Q13.2 (S), Q19.2 (S), Q20.2 (S), Q29.2 (S), Q30.2 (S), Q31.2 (S), Q32.2 (S), Q33.2 (S), Q34.2 (S), Q35.2 (S), Q36.2 (S), Q37.2 (S), R16.2, R23.1, R24.1, R25.1, R26.1, R27.1, R49.1, R52.1, R55.1, R56.1, R57.1, R58.1, R62.1, R65.1, R70.1, R71.1, R72.1, R73.1, R82.1, R83.1, R88.2, R89.2, R94.1, R97.1, R116.2, R117.1, R118.2, R119.1, R122.2, R123.2, R132.1, R133.1, R138.2, R139.2, R144.1, R147.1, R154.1, R166.2, R167.1, R168.2, R169.1, R172.2, R173.2, R180.1, R181.1, R182.2, R183.2, R186.1, R187.1, R194.1, R195.1, R196.2, R197.2, R200.1, R201.1, R207.1, R208.1, R215.1, R216.1, R217.2, R218.2, R221.1, R222.1, R229.1, R230.1, R231.2, R232.2, R235.1, R236.1, R242.1, R243.1, R246.2, R247.2, SW1.1, SW2.1, SW3.1, SW5.1, TP14.1, TP19.1, TP21.1, TP22.1, TP23.1, TP31.1, TP39.1, TP44.1, TP45.1, TP84.1, TP85.1, TP133.1, TP140.1, TP141.1, TP142.1, TP143.1, TP148.1, U1.6 (GND), U1.7 (GND), U2.16 (VSS), U2.30 (VSSA), U2.31 (VREF-), U2.38 (VSS), U2.51 (VSS), U2.61 (VSS), U2.71 (VSS), U2.83 (VSS), U2.94 (VSS), U2.107 (VSS), U2.120 (VSS), U2.130 (VSS), U2.143 (VSS), U3.1 (GND), U4.4 (GND), U5.8 (GND), U5.9 (GND), U5.15 (GND), U6.17 (GND), U6.18 (GND), U6.25 (GND), U7.2 (GND), U8.1 (PGND), U8.5 (AGND), U8.9 (PGND), U9.1 (PGND), U9.5 (AGND), U9.9 (PGND), U10.11 (V-), U11.11 (V-), U12.11 (V-), U13.3 (GND), U14.3 (GND), U15.3 (GND), U16.3 (GND), U17.13 (GND), U17.17 (GND(PPAD)), U18.11 (V-), U19.3 (GND), U20.3 (GND), U21.3 (GND), U22.3 (GND), U23.13 (GND), U23.17 (GND(PPAD)), Y2.2, Y2.4
INPUT1_PIN1_CURRENT_ENABLE: R78.1, TP48.1, U2.114 (PD0)
INPUT1_PIN1_SENSE_VOLTAGE: C97.1, R86.2, R88.1, TP50.1, U2.21 (PF9)
INPUT1_PIN2_DETECT: D15.3 (COM), R92.1, TP52.1, U2.117 (PD3)
INPUT1_PIN5_SCL_uTX_pRX: C103.1, D19.3 (COM), R98.1, R100.1, TP56.1, U2.69 (PB10)
INPUT1_PIN6_ENABLE_N: R104.1, TP60.1, U2.115 (PD1)
INPUT1_PIN6_SDA_uRX_pTX: Q15.2 (S), R110.2, TP66.1, U2.70 (PB11)
INPUT1_PIN6_SENSE_VOLTAGE: C108.1, R120.2, R122.1, TP68.1, U2.22 (PF10)
INPUT2_PIN1_CURRENT_ENABLE: R79.1, TP49.1, U2.126 (PG11)
INPUT2_PIN1_SENSE_VOLTAGE: C98.1, R87.2, R89.1, TP51.1, U2.35 (PA1)
INPUT2_PIN2_DETECT: D16.3 (COM), R95.1, TP53.1, U2.118 (PD4)
INPUT2_PIN5_SCL_uTX_pRX: C105.1, D20.3 (COM), R99.1, R101.1, TP57.1, U2.111 (PC10), U2.129 (PG14)
INPUT2_PIN6_ENABLE_N: R105.1, TP59.1, U2.127 (PG12)
INPUT2_PIN6_SDA_uRX_pTX: Q16.2 (S), R111.2, TP67.1, U2.112 (PC11), U2.128 (PG13)
INPUT2_PIN6_SENSE_VOLTAGE: C109.1, R121.2, R123.1, TP69.1, U2.34 (PA0)
INPUT3_PIN1_CURRENT_ENABLE: R128.1, TP72.1, U2.132 (PG15)
INPUT3_PIN1_SENSE_VOLTAGE: C117.1, R136.2, R138.1, TP74.1, U2.36 (PA2)
INPUT3_PIN2_DETECT: D29.3 (COM), R142.1, TP76.1, U2.134 (PB4)
INPUT3_PIN5_SCL_uTX_pRX: C123.1, D33.3 (COM), R148.1, R150.1, TP80.1, U2.11 (PF1), U2.119 (PD5)
INPUT3_PIN6_ENABLE_N: R107.1, TP61.1, U2.135 (PB5)
INPUT3_PIN6_SDA_uRX_pTX: Q27.2 (S), R160.2, TP90.1, U2.10 (PF0), U2.122 (PD6)
INPUT3_PIN6_SENSE_VOLTAGE: C128.1, R170.2, R172.1, TP92.1, U2.40 (PA4)
INPUT4_PIN1_CURRENT_ENABLE: R129.1, TP73.1, U2.142 (PE1)
INPUT4_PIN1_SENSE_VOLTAGE: C118.1, R137.2, R139.1, TP75.1, U2.37 (PA3)
INPUT4_PIN2_DETECT: D30.3 (COM), R145.1, TP77.1, U2.140 (PB9)
INPUT4_PIN5_SCL_uTX_pRX: C125.1, D34.3 (COM), R149.1, R151.1, TP81.1, U2.124 (PG9)
INPUT4_PIN6_ENABLE_N: R109.1, TP83.1, U2.139 (PB8)
INPUT4_PIN6_SDA_uRX_pTX: Q28.2 (S), R161.2, TP91.1, U2.125 (PG10)
INPUT4_PIN6_SENSE_VOLTAGE: C129.1, R171.2, R173.1, TP93.1, U2.41 (PA5)
MOTORAB_FAULT_N: TP104.1, U2.78 (PD9), U17.8 (nFAULT)
MOTORAB_SLEEP_N: TP103.1, U2.77 (PD8), U17.1 (nSLEEP)
MOTORA_PIN5_DET: R184.1, TP96.1, U2.65 (PE12)
MOTORA_PIN5_ENCODER: R202.1, TP134.1, U2.82 (PD13)
MOTORA_PIN5_SENSE: C133.1, R178.2, R182.1, TP94.1, U2.46 (PB0)
MOTORA_PIN6_DET: R198.1, TP100.1, U2.68 (PE15)
MOTORA_PIN6_ENCODER: R204.1, TP135.1, U2.81 (PD12)
MOTORA_PIN6_SENSE: C138.1, R192.2, R196.1, TP98.1, U2.45 (PC5)
MOTORA_PWM1: TP107.1, U2.99 (PC9), U17.9 (BIN1)
MOTORA_PWM2: TP108.1, U2.98 (PC8), U17.10 (BIN2)
MOTORB_PIN5_DET: R185.1, TP97.1, U2.63 (PE10)
MOTORB_PIN5_ENCODER: R203.1, TP16.1, U2.2 (PE3)
MOTORB_PIN5_SENSE: C134.1, R179.2, R183.1, TP95.1, U2.47 (PB1)
MOTORB_PIN6_DET: R199.1, TP101.1, U2.64 (PE11)
MOTORB_PIN6_ENCODER: R205.1, TP20.1, U2.3 (PE4)
MOTORB_PIN6_SENSE: C139.1, R193.2, R197.1, TP99.1, U2.44 (PC4)
MOTORB_PWM1: TP105.1, U2.96 (PC6), U17.16 (AIN1)
MOTORB_PWM2: TP106.1, U2.97 (PC7), U17.15 (AIN2)
MOTORCD_SLEEP_N: TP122.1, U2.54 (PF14), U23.1 (nSLEEP)
MOTORC_PIN5_DET: R219.1, TP115.1, U2.53 (PF13)
MOTORC_PIN5_ENCODER: R237.1, TP139.1, U2.133 (PB3)
MOTORC_PIN5_SENSE: C158.1, R213.2, R217.1, TP113.1, U2.43 (PA7)
MOTORC_PIN6_DET: R233.1, TP119.1, U2.48 (PB2)
MOTORC_PIN6_ENCODER: R239.1, TP138.1, U2.110 (PA15)
MOTORC_PIN6_SENSE: C163.1, R227.2, R231.1, TP117.1, U2.28 (PC2)
MOTORC_PWM1: TP126.1, U2.67 (PE14), U23.9 (BIN1)
MOTORC_PWM2: TP127.1, U2.66 (PE13), U23.10 (BIN2)
MOTORD_PIN5_DET: R220.1, TP116.1, U2.50 (PF12)
MOTORD_PIN5_ENCODER: R238.1, TP136.1, U2.76 (PB15)
MOTORD_PIN5_SENSE: C159.1, R214.2, R218.1, TP114.1, U2.42 (PA6)
MOTORD_PIN6_DET: R234.1, TP120.1, U2.49 (PF11)
MOTORD_PIN6_ENCODER: R240.1, TP137.1, U2.75 (PB14)
MOTORD_PIN6_SENSE: C164.1, R228.2, R232.1, TP118.1, U2.29 (PC3)
MOTORD_PWM1: TP124.1, U2.100 (PA8), U23.16 (AIN1)
MOTORD_PWM2: TP125.1, U2.101 (PA9), U23.15 (AIN2)
MOTOR_CD_FAULT_N: TP123.1, U2.58 (PE7), U23.8 (nFAULT)
unnamed: C84.1, R63.1
unnamed: C85.1, R156.1
unnamed: C94.2, F3.1, J7.4
unnamed: C99.2, F4.1, J8.4
unnamed: C114.2, F5.1, J9.4
unnamed: C119.2, F6.1, J10.4
unnamed: C132.2, F7.1, J11.4
unnamed: C135.2, F8.1, J12.4
unnamed: C157.2, F9.1, J13.4
unnamed: C160.2, F10.1, J14.4
unnamed: C183.2, R246.1
unnamed: C184.2, R247.1
unnamed: D1.1 (K), R23.2
unnamed: D2.1 (K), R24.2
unnamed: D3.1 (K), R25.2
unnamed: D8.1 (K), R45.2
unnamed: D9.1 (K), R47.2
unnamed: D10.1 (K), R56.2
unnamed: C184.1, D11.2 (A), L2.2, U8.8 (SW)
unnamed: C183.1, D12.2 (A), L3.2, U9.8 (SW)
unnamed: D13.3 (COM), R84.1, U10.3 (+)
unnamed: D14.3 (COM), R85.2, U10.12 (+)
unnamed: D23.3 (COM), R112.1, TP62.1, U10.5 (+)
unnamed: D24.3 (COM), R114.1, TP64.1, U10.10 (+)
unnamed: D27.3 (COM), R134.2, U11.3 (+)
unnamed: D28.3 (COM), R135.2, U11.12 (+)
unnamed: D37.3 (COM), R162.1, TP86.1, U11.5 (+)
unnamed: D38.3 (COM), R164.1, TP88.1, U11.10 (+)
unnamed: D65.2 (DIN), R152.2
unnamed: D65.4 (DO), TP149.1
unnamed: J2.8 (GPIO14/TXD), R5.2
unnamed: J2.10 (GPIO15/RXD), R9.2
unnamed: J3.A5 (CC1), R29.1
unnamed: J3.B5 (CC2), R30.1
unnamed: J3.A6 (D+), J3.B6 (D+), R34.1
unnamed: J3.A7 (D-), J3.B7 (D-), R32.1
unnamed: Q1.3 (D), Q2.2 (S)
unnamed: Q1.1 (G), R13.1
unnamed: Q2.1 (G), R15.1
unnamed: Q3.3 (D), R43.2
unnamed: Q3.1 (G), R42.2, R50.1, TP33.1
unnamed: Q3.2 (S), R42.1, R206.2
unnamed: Q4.3 (D), R50.2
unnamed: Q4.1 (G), R54.2, R58.2
unnamed: Q5.3 (D), R80.2
unnamed: Q5.1 (G), Q7.3 (D), R76.1
unnamed: Q6.3 (D), R81.2
unnamed: Q6.1 (G), Q8.3 (D), R77.1
unnamed: Q7.1 (G), R78.2, R82.2
unnamed: Q8.1 (G), R79.2, R83.2
unnamed: Q9.1 (G), R103.1, R105.2
unnamed: Q10.3 (D), Q15.1 (G), R117.2
unnamed: Q10.1 (G), R102.1, R104.2
unnamed: Q11.3 (D), Q27.1 (G), R167.2
unnamed: Q11.1 (G), R106.1, R107.2
unnamed: Q12.3 (D), Q28.1 (G), R169.2
unnamed: Q12.1 (G), R108.1, R109.2
unnamed: Q13.3 (D), TP146.1
unnamed: Q13.1 (G), R153.1, R154.2
unnamed: Q14.1 (G), R64.1, R157.2
unnamed: Q15.3 (D), R113.1
unnamed: Q16.3 (D), R115.1
unnamed: Q9.3 (D), Q16.1 (G), R119.2
unnamed: Q17.3 (D), R130.2
unnamed: Q17.1 (G), Q19.3 (D), R126.1
unnamed: Q18.3 (D), R131.2
unnamed: Q18.1 (G), Q20.3 (D), R127.1
unnamed: Q19.1 (G), R128.2, R132.2
unnamed: Q20.1 (G), R129.2, R133.2
unnamed: Q21.1 (G), R158.1, R159.2
unnamed: Q27.3 (D), R163.1
unnamed: Q28.3 (D), R165.1
unnamed: Q29.3 (D), R241.2
unnamed: Q29.1 (G), R184.2, R186.2
unnamed: Q30.3 (D), R249.2
unnamed: Q30.1 (G), R185.2, R187.2
unnamed: Q31.3 (D), R244.2
unnamed: Q31.1 (G), R198.2, R200.2
unnamed: Q32.3 (D), R248.2
unnamed: Q32.1 (G), R199.2, R201.2
unnamed: Q33.3 (D), R155.2
unnamed: Q33.1 (G), R219.2, R221.2
unnamed: Q34.3 (D), R251.2
unnamed: Q34.1 (G), R220.2, R222.2
unnamed: Q35.3 (D), R245.2
unnamed: Q35.1 (G), R233.2, R235.2
unnamed: Q36.3 (D), R250.2
unnamed: Q36.1 (G), R234.2, R236.2
unnamed: Q37.3 (D), R31.1, R35.2
unnamed: R10.1, SW5.2
unnamed: R11.1, SW1.2
unnamed: R12.1, SW2.2
unnamed: R51.1, R55.2
unnamed: R60.1, R61.1
unnamed: R93.1, R94.2
unnamed: R96.1, R97.2
unnamed: R143.1, R144.2
unnamed: R146.1, R147.2
unnamed: R202.2, U13.4
unnamed: R203.2, U14.4
unnamed: R204.2, U15.4
unnamed: R205.2, U16.4
unnamed: R237.2, U19.4
unnamed: R238.2, U20.4
unnamed: R239.2, U21.4
unnamed: R240.2, U22.4
unnamed: R1.1, U1.3 (SCX)
unnamed: R2.1, U1.2 (SDX)
unnamed: TP132.1, U2.12 (PF2)
unnamed: R17.1, U4.7 (~HOLD)
unnamed: R18.1, U4.3 (~WP)
unnamed: R38.2, U5.5 (INT_N)
unnamed: R37.2, U5.6 (SCL)
unnamed: R36.2, U5.7 (SDA)
unnamed: C54.2, U6.21 (BTST)
unnamed: C65.1, U6.23 (PMID)
unnamed: R52.2, U6.2 (PSEL)
unnamed: R46.2, U6.5 (SCL)
unnamed: R44.2, U6.6 (SDA)
unnamed: R53.1, R57.2, TP58.1, U6.11 (TS)
unnamed: R49.2, U6.9 (~CE)
unnamed: R48.2, U6.7 (~INT)
unnamed: C82.1, R63.2, U8.4 (COMP)
unnamed: R59.1, R62.2, U8.6 (FB)
unnamed: C80.1, U8.7 (SS)
unnamed: C83.1, R156.2, U9.4 (COMP)
unnamed: R61.2, R65.2, U9.6 (FB)
unnamed: C81.1, U9.7 (SS)
unnamed: R86.1, U10.1, U10.2 (-)
unnamed: R120.1, U10.6 (-), U10.7
unnamed: R121.1, U10.8, U10.9 (-)
unnamed: R87.1, U10.13 (-), U10.14
unnamed: R136.1, U11.1, U11.2 (-)
unnamed: R170.1, U11.6 (-), U11.7
unnamed: R171.1, U11.8, U11.9 (-)
unnamed: R137.1, U11.13 (-), U11.14
unnamed: R192.1, U12.1, U12.2 (-)
unnamed: R193.1, U12.6 (-), U12.7
unnamed: R179.1, U12.8, U12.9 (-)
unnamed: R178.1, U12.13 (-), U12.14
unnamed: R207.2, U17.3 (AISEN)
unnamed: R208.2, U17.6 (BISEN)
unnamed: C150.2, U17.11 (VCP)
unnamed: C149.1, U17.14 (VINT)
unnamed: R227.1, U18.1, U18.2 (-)
unnamed: R228.1, U18.6 (-), U18.7
unnamed: R214.1, U18.8, U18.9 (-)
unnamed: R213.1, U18.13 (-), U18.14
unnamed: R242.2, U23.3 (AISEN)
unnamed: R243.2, U23.6 (BISEN)
unnamed: C175.2, U23.11 (VCP)
unnamed: C174.1, U23.14 (VINT)
PIEZO_PWM: R153.2, TP145.1, U2.141 (PE0)
PM_NIRQ: R33.1, R38.1, U2.85 (PD14)
SHUTDOWN: C46.1, R35.1, TP25.1, U2.79 (PD10)
SYS_I2C_SCL: R19.1, R37.1, R39.1, R46.1, TP30.1, U2.26 (PC0), U3.3 (SCL)
SYS_I2C_SDA: R20.1, R36.1, R40.1, R44.1, TP29.1, U2.27 (PC1), U3.4 (SDA)
USB_DN: D5.1 (K), R32.2, U2.103 (PA11)
USB_DP: D4.1 (K), R34.2, U2.104 (PA12)
VBAT_ADC_ON: R54.1, TP38.1, U2.91 (PG6)
VBAT_SENSE: C58.1, R43.1, R51.2, TP34.1, U2.18 (PF6)
VBUS: C41.1, C49.1, C50.1, C52.1, J3.A4 (VBUS), J3.A9 (VBUS), J3.B4 (VBUS), J3.B9 (VBUS), R66.2, TP82.1, U5.2 (VBUS), U6.1 (VAC), U6.24 (VBUS)
VBUS_SENSE: C86.1, R66.1, R70.2, U2.19 (PF7)
