sgoldaraz/mcu-board/(commit log)

2025-04-13 Add rev b support. Initial copy
    [01-Microcontroller and Extras.kicad_sch, 02-System Power Supply and USB.kicad_sch, 03-System Inputs A.kicad_sch, 04-System Inputs B.kicad_sch, 05-System Outputs A.kicad_sch, 06-System Outputs B.kicad_sch, BOMRobotLegoController.csv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]
2025-04-25 Add rev A schematic
2025-04-26 Finish updating schematic REV B
    [01-Microcontroller and Extras.kicad_sch, 02-System Power Supply and USB.kicad_sch, 03-System Inputs A.kicad_sch, 04-System Inputs B.kicad_sch, 05-System Outputs A.kicad_sch, 06-System Outputs B.kicad_sch, RobotLegoController.kicad_sch]
2025-04-26 More pcb routing for rev b
    [RobotLegoController.kicad_pcb]
2025-04-26 Alignment of the top connectors
    [RobotLegoController.kicad_pcb]
2025-05-04 More work on pcb layout
    [RobotLegoController.kicad_pcb]
2025-05-05 More output layout done
    [RobotLegoController.kicad_pcb]
2025-05-05 Finish with the pcb layout.
    [RobotLegoController.kicad_pcb]
